hutscape/cactus/readme.md

# Cactus

> 🌵 Indoor WiFi-connected temperature and humidity sensor 🍶

Visit [hutscape.com/cactus](https://hutscape.com/cactus/) for more details.

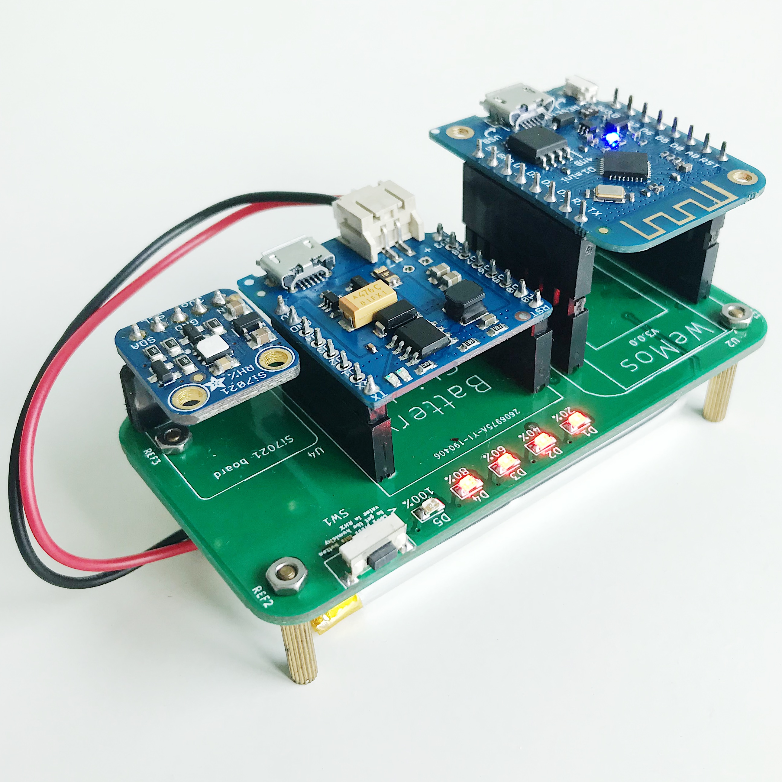
[picture p1: images/prototype/front.jpg]
