hutscape/cactus/hardware/readme.md

# Hardware

View the [schematic](images/schematic.pdf) and [footprint](images/footprint.pdf) in PDF format.

## Main components

1. PCB (1x)
1. WeMos D1 Mini `v3.0.0` (1x)
1. WeMos Battery shield `v1.1.0` (1x)
1. LiPo `1200mAh` battery with JST PH2 connector (1x)
1. `M2` nuts (4x)
1. `M2` spacers `15mm` height (4x)

Connect pins `A0` and positive `+` terminal of the LiPo JST connector on the battery shield with a `100k ohm` resistor.

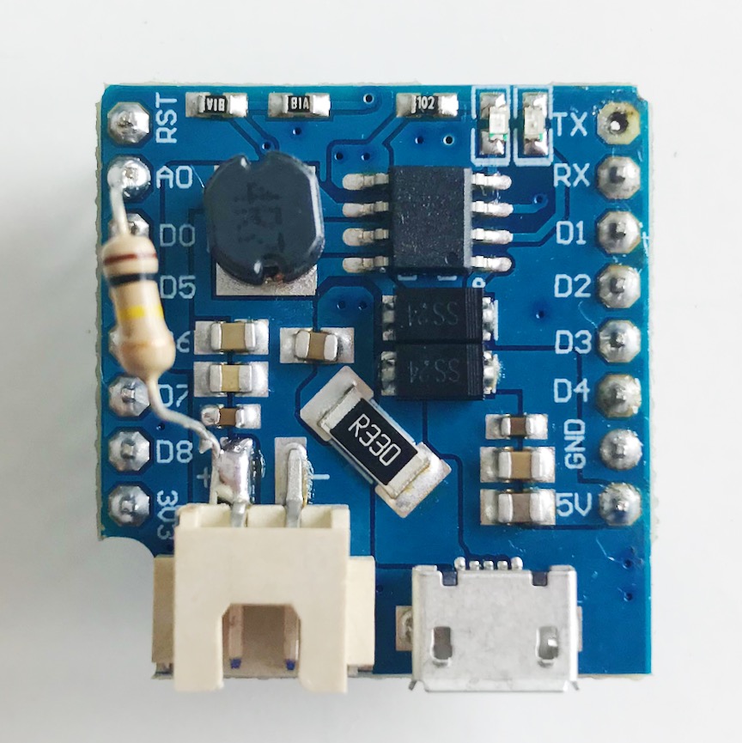
[picture p2: hardware/images/battery-shield.jpg]


## Prototype

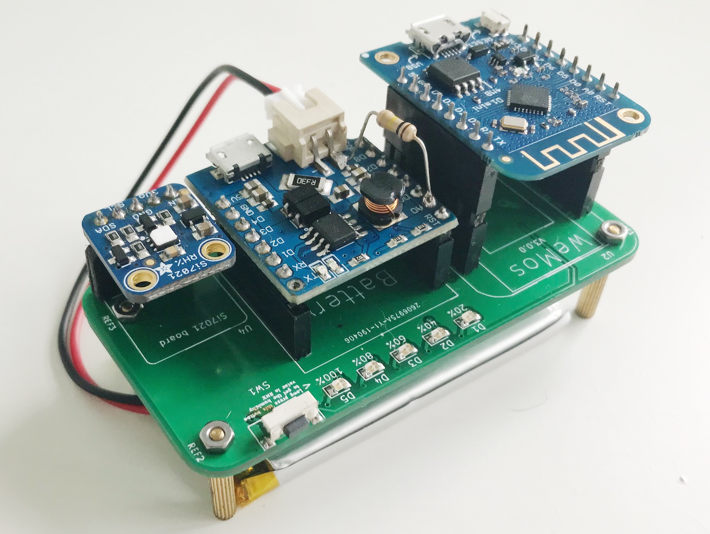
[picture p3: hardware/images/prototype-back.jpg]

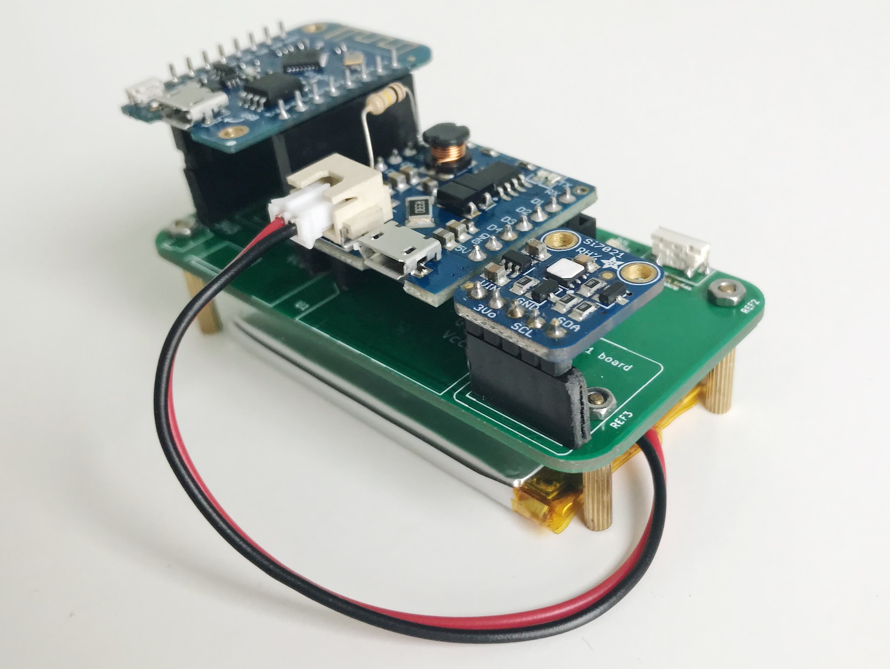
[picture p4: hardware/images/prototype-front.jpg]

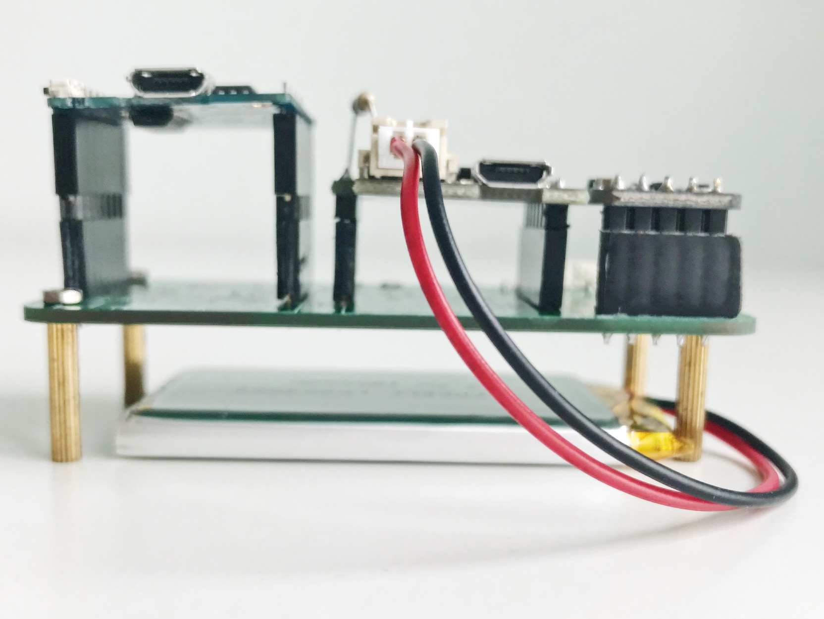
[picture p5: hardware/images/prototype-side.jpg]

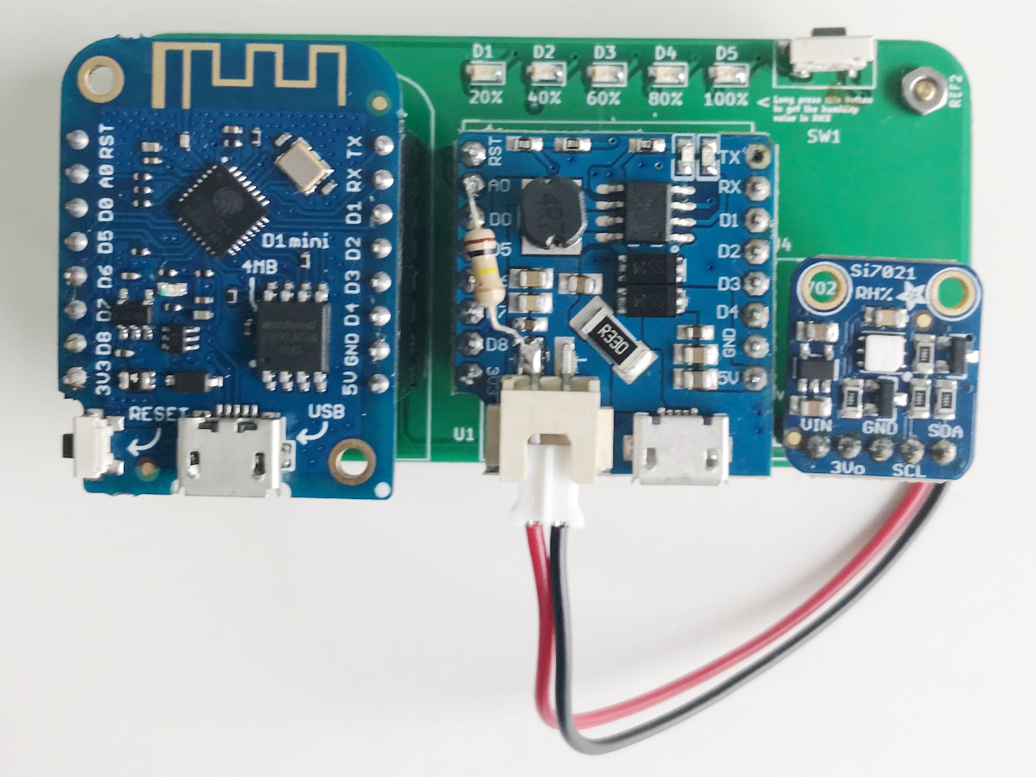
[picture p6: hardware/images/prototype-top.jpg]


## Schematic

View the [PDF](images/schematic.pdf) version

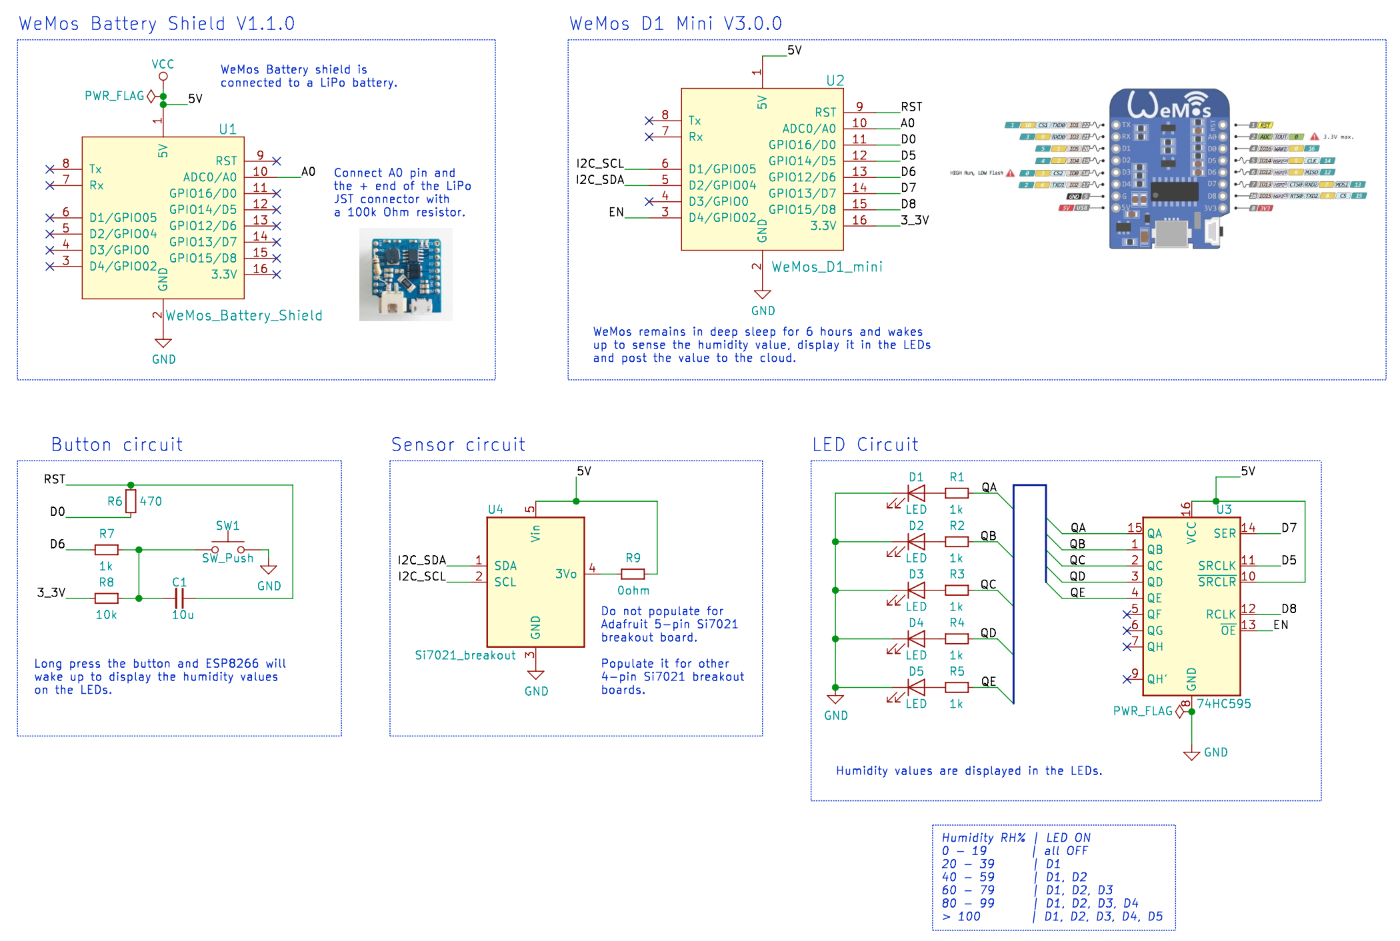
[picture p7: hardware/images/schematic.png]


## Footprint

View [PDF](images/footprint.pdf) version

Front

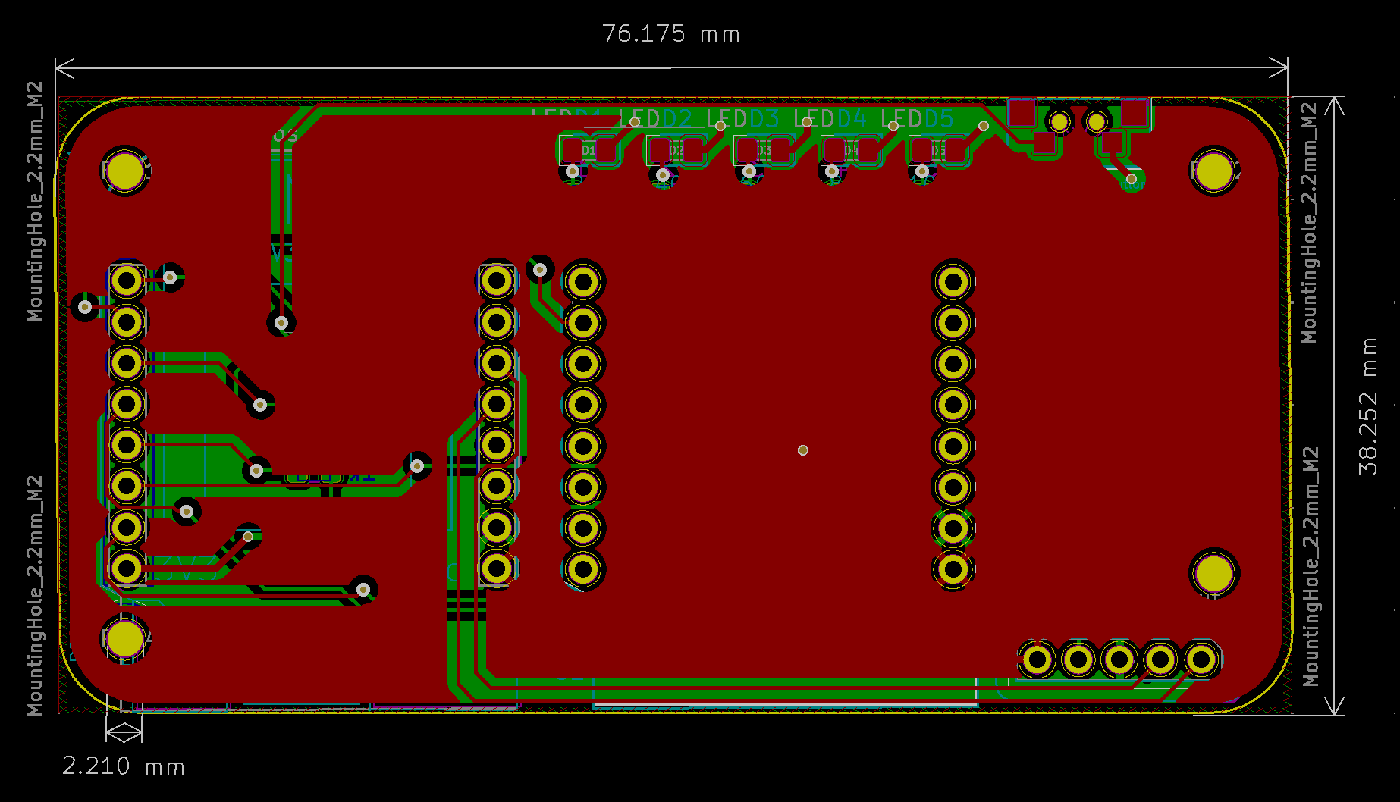
[picture p8: hardware/images/footprint-front.png]


Back

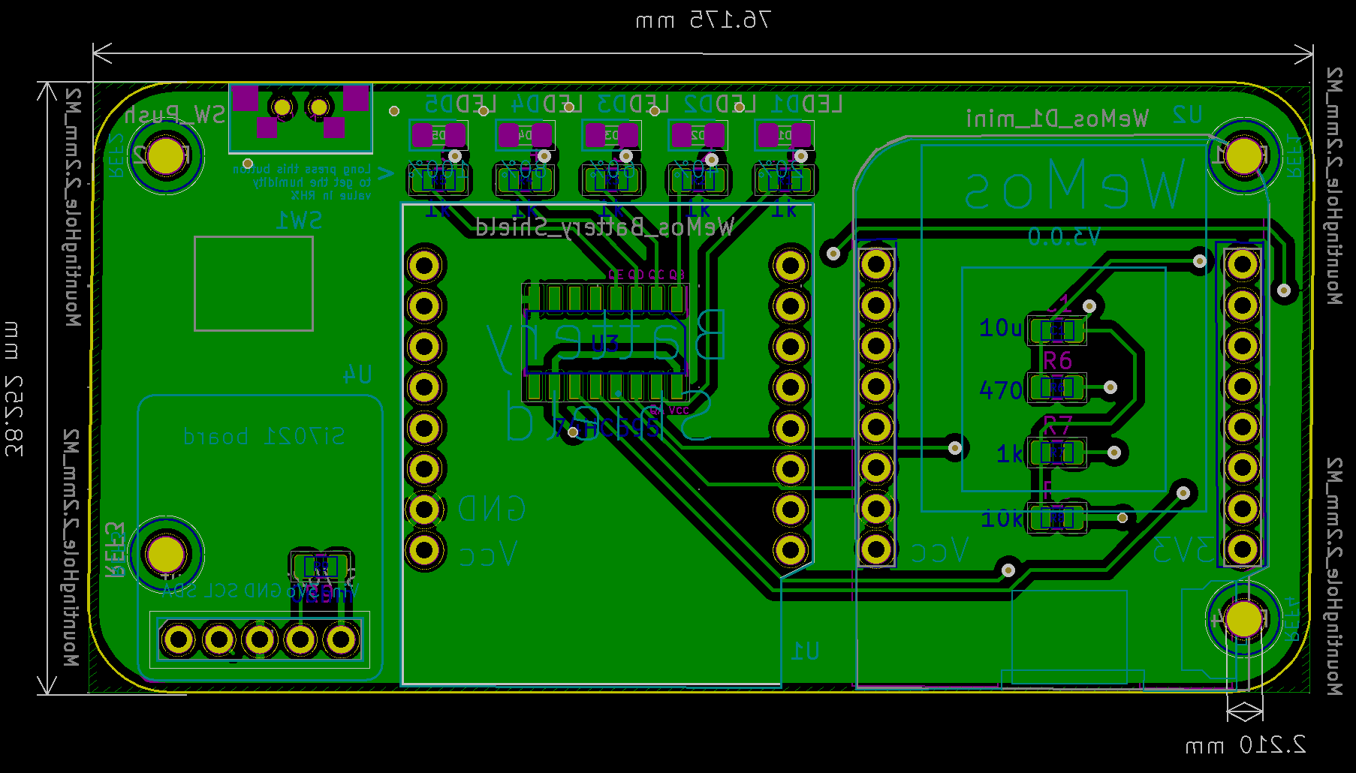
[picture p9: hardware/images/footprint-back.png]


## 3D View

Front

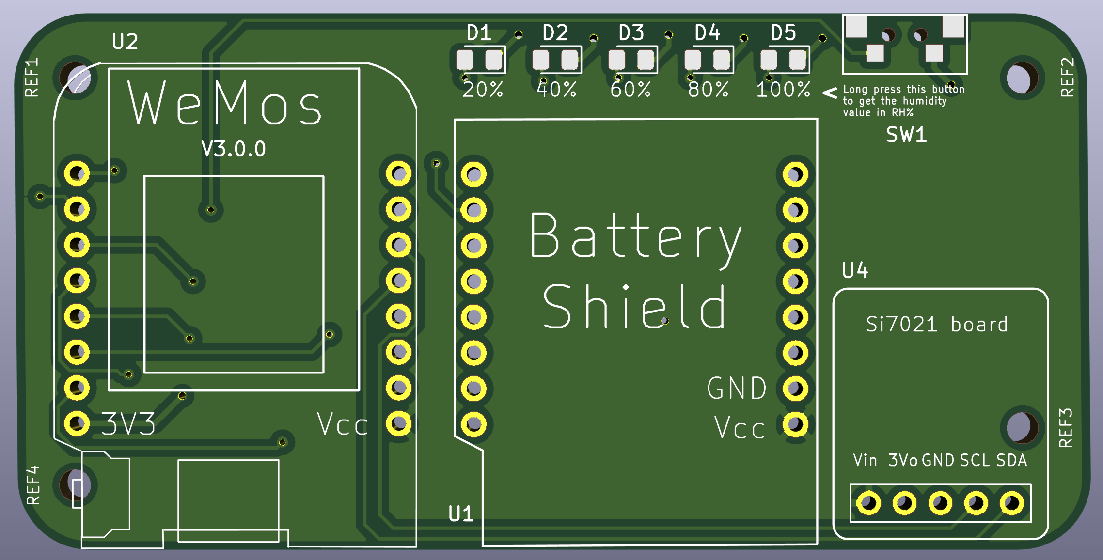
[picture p10: hardware/images/3dview-front.png]


Back

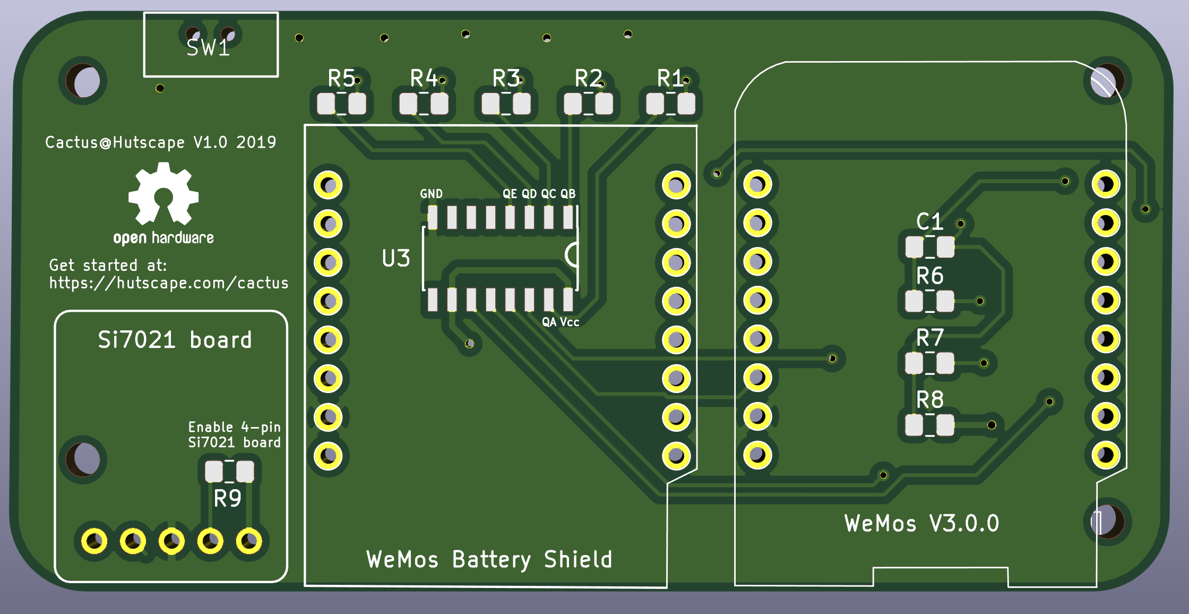
[picture p11: hardware/images/3dview-back.png]
