hutscape/cactus/design.md

---
layout: design
title: Design
permalink: /design
sequence: 5
state_machine: true

# Mechanical
items:
  - name: Name card holder box
    url: https://www.adafruit.com/product/3406
    height: 90
    width: 55
    depth: 25
    dimension_unit: mm
    comment: enclosure

  - name: PCB
    height: 76
    width: 38
    depth: 2
    dimension_unit: mm

  - name: WeMos D1 Mini V3.0.0
    url: https://wiki.wemos.cc/products:d1:d1_mini
    height: 34.2
    width: 25.6
    depth: 2
    dimension_unit: mm
    weight: 3
    weight_unit: g
    comment: pcb fit

  - name: WeMos Battery shield
    url: https://wiki.wemos.cc/products:d1_mini_shields:battery_shield
    height: 34.2
    width: 25.6
    depth: 2
    dimension_unit: mm
    comment: pcb fit

  - name: Adafruit Si7021 Breakout Board
    url: https://www.adafruit.com/product/3251
    height: 17.8
    width: 15.3
    depth: 3
    dimension_unit: mm
    weight: 1
    weight_unit: g
    comment: pcb fit

  - name: <code>500mAh</code> LiPo
    url: https://www.adafruit.com/product/1578
    height: 36
    width: 29
    depth: 4.75
    dimension_unit: mm
    weight: 10.5
    weight_unit: g
    comment: pcb fit

  - name: <code>500mAh</code> LiPo
    url: https://www.aliexpress.com/item/3-7V-500mAh-Lipo-Battery-For-Syma-X5C-X5SW-M68-Cheerson-CX-30-H5C-Quadrocopter-3/32918919539.html
    height: 43
    width: 25
    depth: 8
    dimension_unit: mm
    comment: pcb fit

  - name: <code>2000mAh</code> LiPo
    url: https://www.adafruit.com/product/2011
    height: 60
    width: 36
    depth: 7
    dimension_unit: mm
    weight: 34
    weight_unit: g
    comment: pcb fit

  - name: <code>2000mAh</code> LiPo
    url: https://www.aliexpress.com/item/3-7V-2000-mAh-Polymer-Lithium-Battery-LiPo-For-GPS-Tablet-PC-407080/2055208577.html
    height: 80
    width: 70
    depth: 4
    dimension_unit: mm

  - name: <code>2500mAh</code> LiPo
    url: https://www.adafruit.com/product/328
    height: 65
    width: 51
    depth: 8
    dimension_unit: mm
    weight: 52
    weight_unit: g
---
