hutscape/cactus/timeline.md

# Timeline

## Total duration

- **Start Date:** 10 May 2017
- End Date:

## Ideation

- **Ideation Duration:** *Not tracked*
- **Ideation Start Date:** *Not tracked*
- **Ideation End Date:** *Not tracked*
- **Prototype Parts Lead Time:** *Not tracked*
- **Order prototype parts date:** *Not tracked*
- **Receive prototype parts date:** *Not tracked*

Ideation tasks:

1. Research for modules
1. Research for similar projects
1. Research for datasheets
1. Settle on a project name
1. Research on power
1. Order modules, parts, power required for component testing
1. Note the prices for prototype items
1. Note the time taken to receive all the parts

## Prototyping

- **Prototype Testing Duration:** *Not tracked*
- **Prototype Testing Start Date:** *Not tracked*
- **Prototype Testing End Date:** *Not tracked*

Prototyping tasks:

- [x] Ensure various components work with both hardware modules and firmware
- [x] Finalize the power tree
- [x] Make a theoretical power consumption calculation
- [x] Make a mechanical and physical layout of the PCB housing

## Schematic

- **Schematic Duration:** 7 Days
- **Schematic Start Date:** [Mar 12, 2019](https://github.com/sayanee/cactus/commit/ff585d7c6959faede793e362a63a2719848d49f6)
- **Schematic End Date:** [Mar 19, 2019](https://github.com/sayanee/cactus/commit/a69e2ad4a81ffa1c7960dc5ee44be5a643a09f90)

Schematic tasks:

- [x] Create new components
- [x] Ensure DRC passes

## Mechanical

- **Mechanical Testing duration:** 9 Days
- **Mechanical Testing Start Date:** [Mar 20, 2019](https://github.com/sayanee/cactus/commit/9eb6e6a9e616c000224ddb287a9347f35d2da6c7)
- **Mechanical Testing End Date:** [Mar 29, 2019](https://github.com/sayanee/cactus/commit/85a2da56949accfd0cb8a94280c2dceeae0b87dc)

Mechanical tasks:

- [x] Create a BOM list
- [x] Ensure vendors have the stock
- [x] Ensure edge cuts can house all the components
- [x] Note all the dimensions of major components
- [x] Note all connectors to external links
- [x] Layout the PCB footprint
- [x] Ensure ERC passes
- [x] Add version, name, year, logos on the silkscreen
- [x] Add mounting holes

## Manufacturing

- **BOM receive Duration:** 16 days
- **BOM Order Date:** 4 April, 2019
- **BOM receive Date:** 22 April, 2019
- **BOM vendors:** 4 (Mouser, RS, AliExpress, 12Geeks)
- **Manufacturing PCB Duration:** 7 days
- **Manufacturing PCB Order Date:** 5 April, 2019
- **Manufacturing PCB Receive Date:** 12 April, 2019

Manufacturing tasks:

- [x] Order BOM parts online
- [x] Order PCB manufacturing online
- [ ] Note the cost per unit
- [ ] Note other charges

## System Integration

- **Integration Duration:** *Pending*
- **Integration Start Date:** 15 April, 2019
- **Integration End Date:** *Pending*

System Integration tasks:

- [x] Solder 1 unit
- [x] Ensure continuity check for all power pins
- [x] Do a power on test
- [x] Run the test firmware
- [ ] Run the full firmware

## Deployment

- **Start logging:** *Pending*

Deployment tasks:

- Start logging to monitor power consumption
