hutscape/cactus/_code/demo.md

---
layout: code
title: Demo
description: Wakup every 6 hours to read the temperature and humidity
difficulty: medium
features:
  - temperature
  - humidity
  - wifi
  - ifttt
images:
  console: demo-console.png
photos:
  - filename: serial-1.png
  - filename: serial-2.png
---

Wakeup every 6 hours to read the temperature and humidity and send that value to IFTTT.
