hutscape/cactus/pcb/pcb.md

---
layout: pcb
title: PCB
permalink: /pcb
sequence: 2

# maximum number of images prototype-n.jpg in folder images/pcb/prototype
max_prototype_images: 2
---
