hutscape/cactus/images/code/demo-console.png

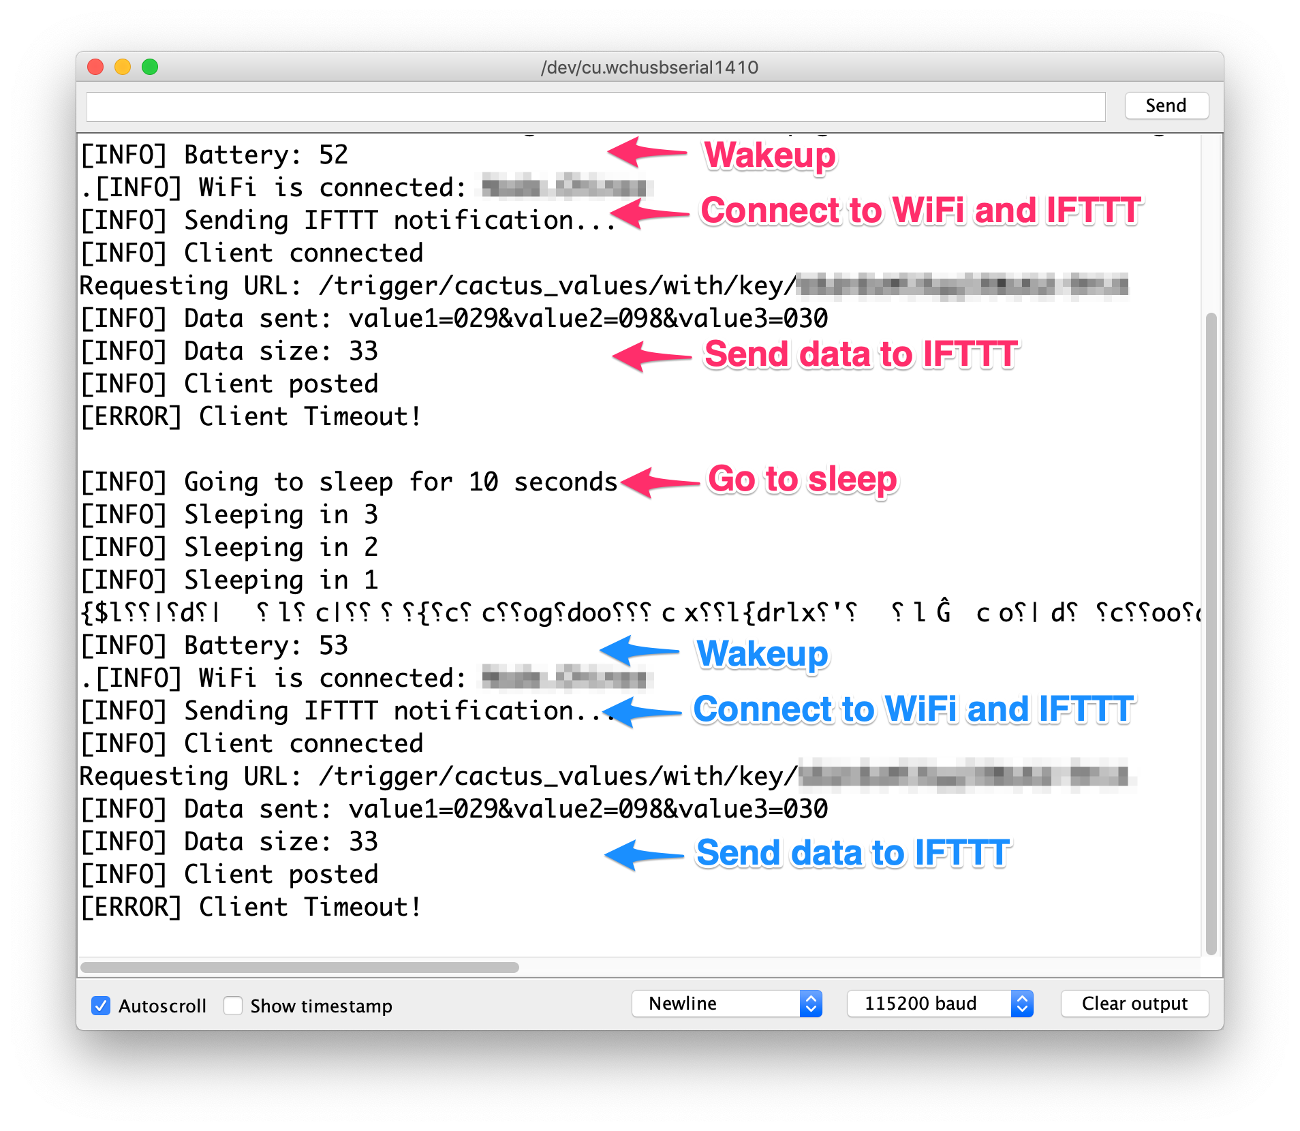
images/code/demo-console.png
