hutscape/cactus/images/code/serial-1.png

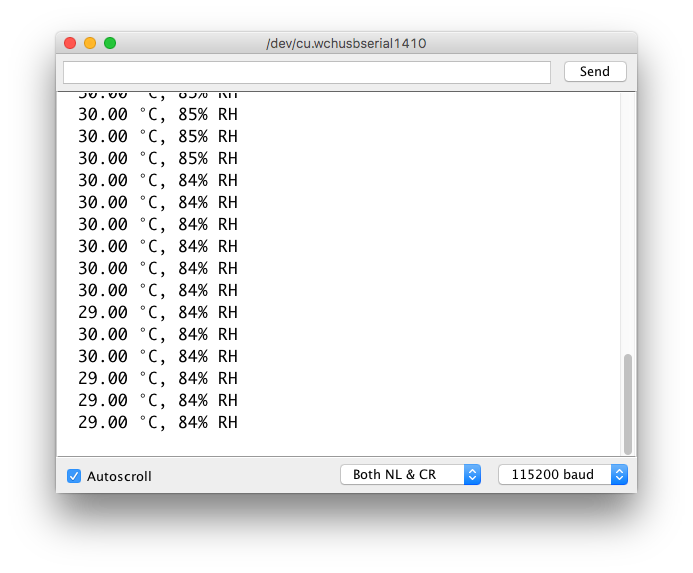
images/code/serial-1.png
