hutscape/cactus/images/code/serial-2.png

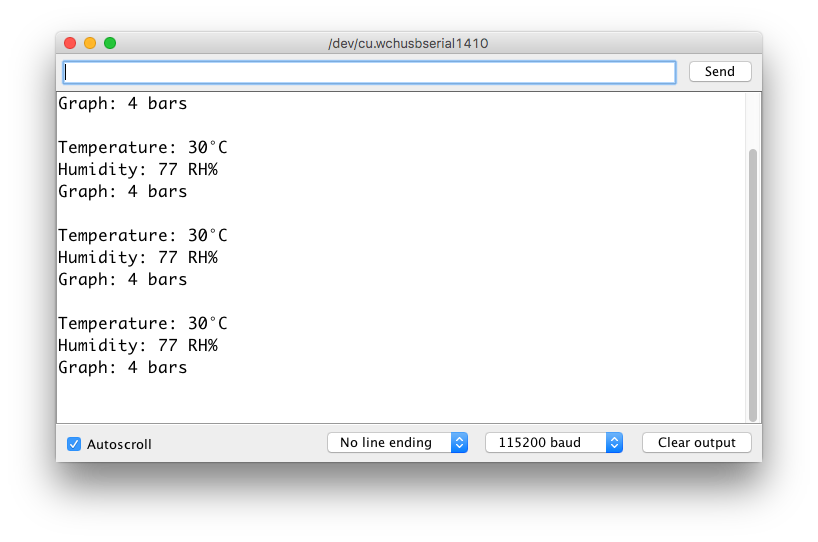
images/code/serial-2.png
