hutscape/cactus/images/code/settings.png

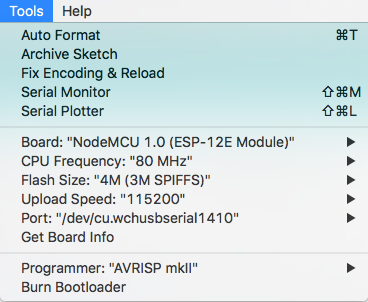
images/code/settings.png
