hutscape/cactus/images/prototype/back.jpg

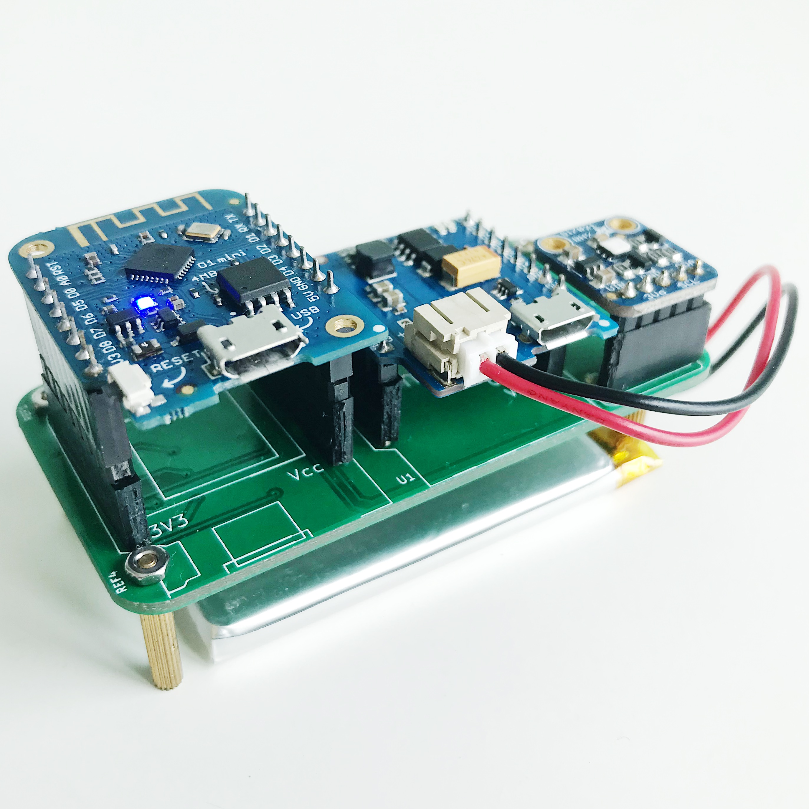
images/prototype/back.jpg
