hutscape/cactus/images/prototype/prototype-1.jpg

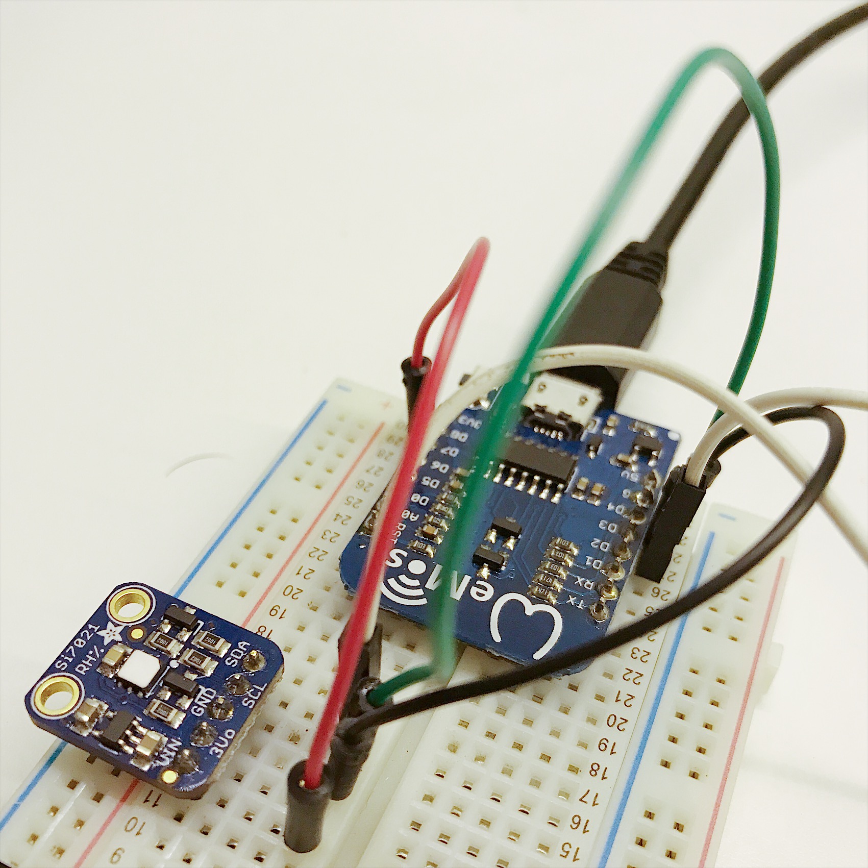
images/prototype/prototype-1.jpg
