hutscape/cactus/images/prototype/side.jpg

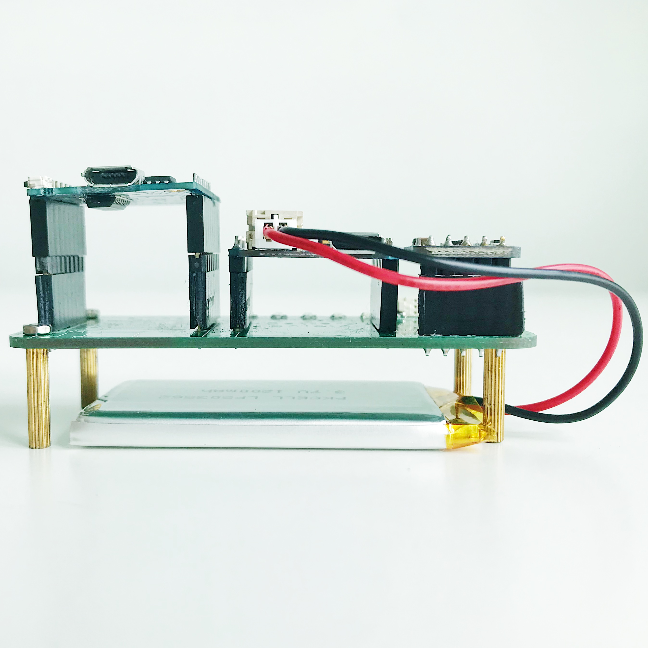
images/prototype/side.jpg
