hutscape/cactus/images/prototype/top.jpg

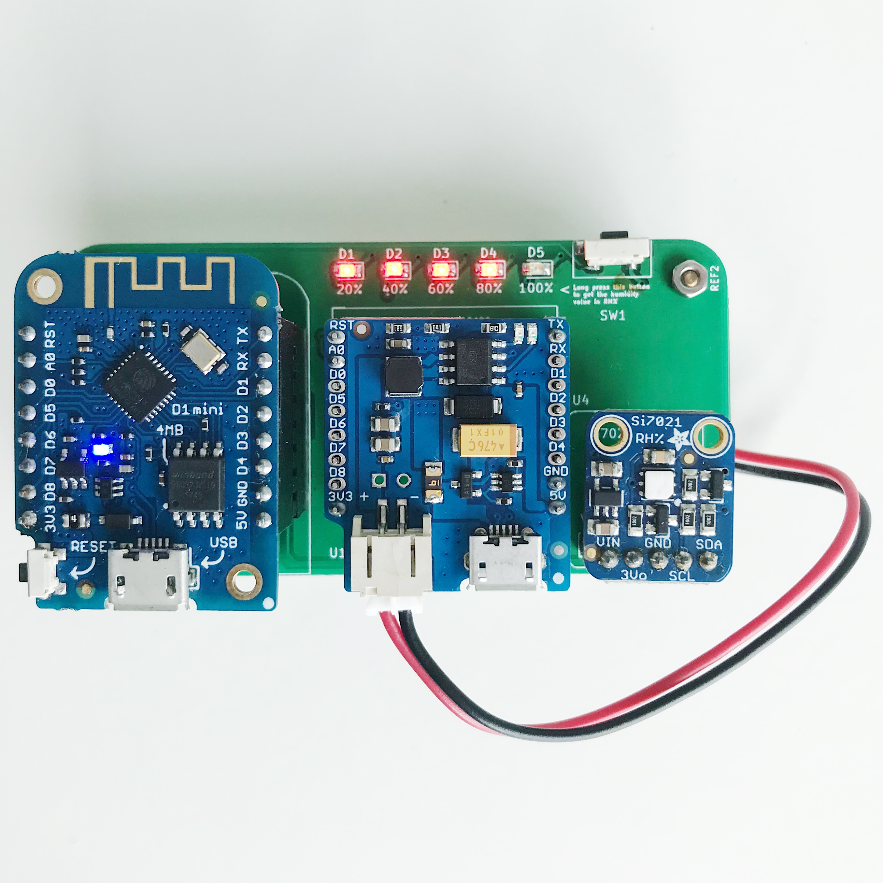
images/prototype/top.jpg
