hutscape/cactus/components/ifttt/readme.md

# IFTTT

Display humidity in a bar graph LED and send to IFTTT periodically

## Hardware

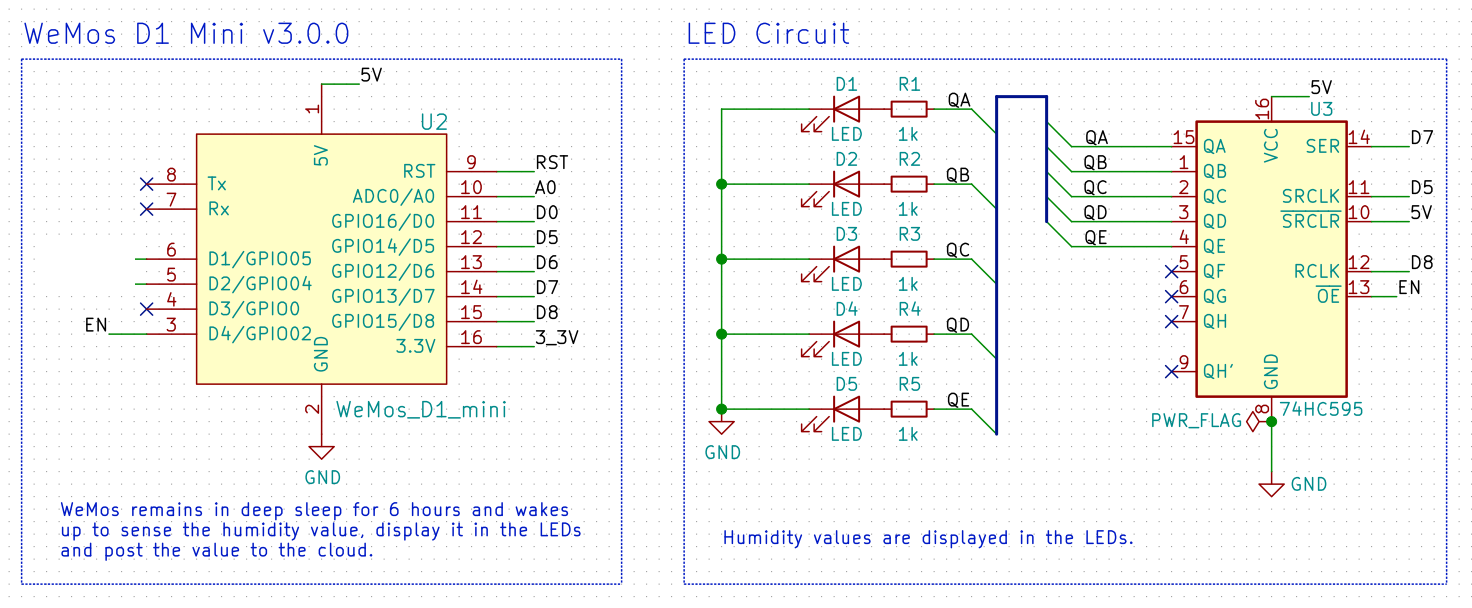
[picture p29: components/shift-register/schematic.png]
Shift register


## Firmware

[Arduino code](main.ino)
