hutscape/cactus/bom.md

---
layout: bom
title: Bill of Materials
permalink: /bom
sequence: 4
ibom: true
---
