hutscape/cactus/start/step3.md

**Update Google Sheets with the data**

Press on-board button or wait for the [Google Sheet](https://docs.google.com/spreadsheets/d/1qedLXiCeU6vCwEvv3JqwrVWjrriB8L3DA9Xp-g01Jk0/edit?usp=sharing) to update with a new row with a periodic update to the cloud.

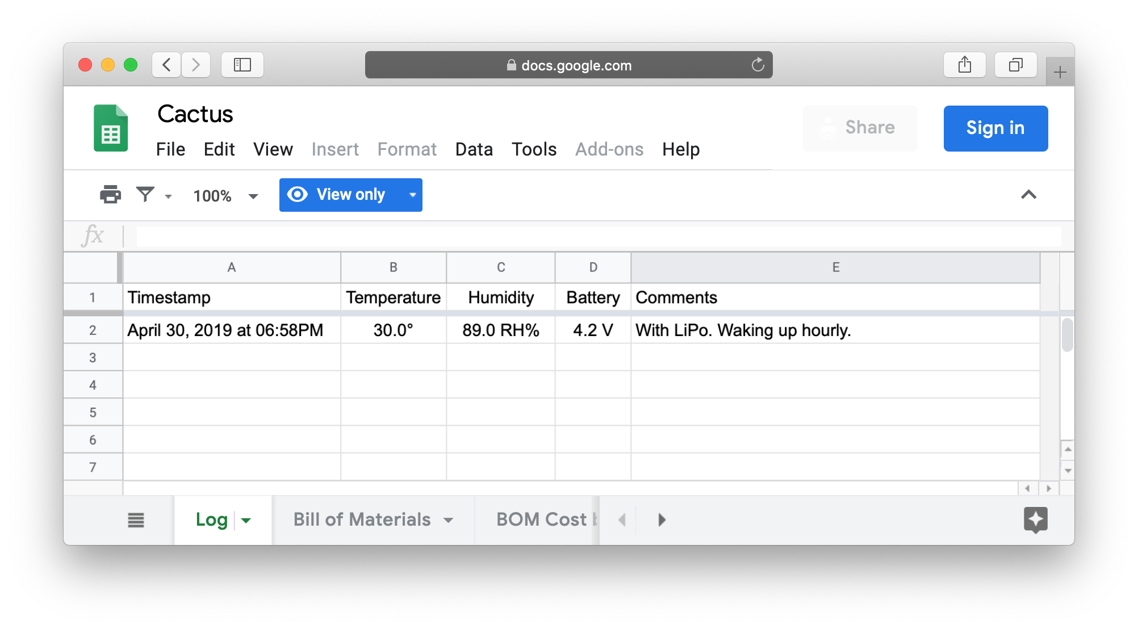
[picture p30: images/start/google-sheet.png]
Google sheets
