hutscape/cactus/start/step1.md

Setup an [IFTTT webhook](https://ifttt.com/services/maker_webhooks) to receive a POST request with data and add a row to a Google Spreadsheet.

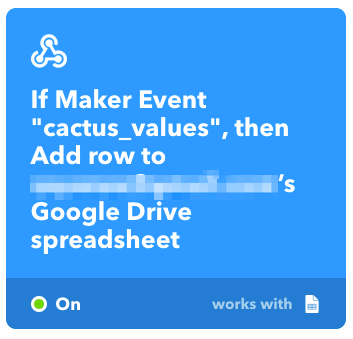
[picture p31: images/start/ifttt.png]
