hutscape/cactus/start/step2.md

**Access Point**

Connect to the WiFi access point `Cactus {UNIQUE_MAC_ADDRESS}`.

Go to the web page `http://cactus.local` to fill in the WiFi credentials and [IFTTT webhook key](https://ifttt.com/services/maker_webhooks/settings).

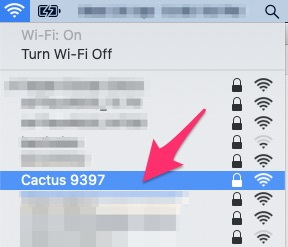
[picture p32: images/start/access_point.jpg]
Access point


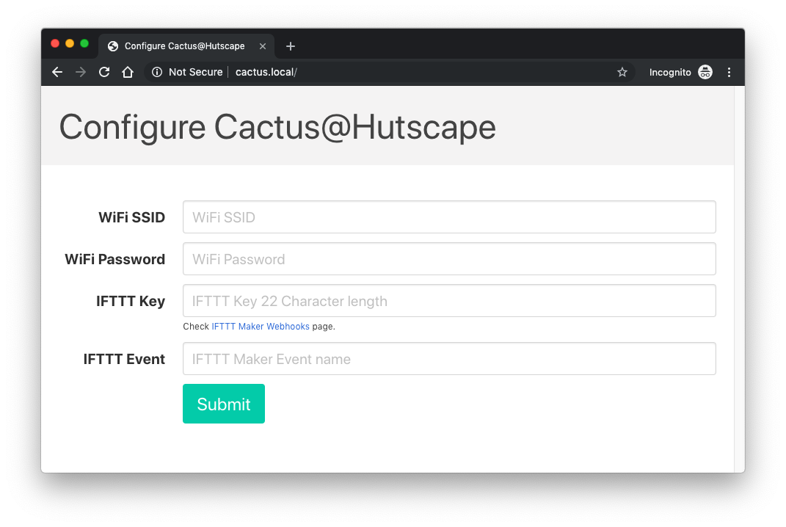
[picture p33: images/start/webpage.png]
Webpage form
