hutscape/cactus/components/measure-battery-level/readme.md

# Measure Battery Level

> Measure the LiPo battery voltage

## Getting started

1. Connect `100k` resistor from `A0` to JST connector's positive terminal
1. Flash the [firmware](measure-battery-level.ino)
1. Connect to access point `Cactus XXXX` with password `hutscape`
1. Get the current battery voltage by accessing `192.168.4.1`

## Reference

- [Monitoring LiPo battery voltage with Wemos D1 minibattery shield and Thingspeak](https://arduinodiy.wordpress.com/2016/12/25/monitoring-lipo-battery-voltage-with-wemos-d1-minibattery-shield-and-thingspeak/)
