hutscape/cactus/_code/test.md

---
layout: code
title: Cactus test
description: Test that all features work
difficulty: medium
features:
  - temperature
  - humidity
  - wifi
  - ifttt
images:
  console: test-console.png
photos:
  - filename: serial-1.png
  - filename: serial-2.png
---
Run a suite of 10 tests.
