hutscape/cactus/(threads)

Thread 1 (2017-06-12):

read and display humidity on push button

sayanee, 2017-06-12:
## Components

1.  📊 [LED](http://sg.element14.com/multicomp/mcl-s290yc/led-smd-0603-yellow/dp/1581246) SMD single color x 5 for bar chart
    - [bar graph LED tutorial](https://www.arduino.cc/en/Tutorial/BarGraph)
    - [LED tutorial](https://learn.adafruit.com/adafruit-arduino-lesson-4-eight-leds?view=all)
1. 🔘 [push button](http://sg.element14.com/omron-electronic-components/b3fs-1000/switch-spst-no-0-05a-24vdc-smd/dp/3121161) SMD
1. [Shift register](http://sg.element14.com/nxp/74hc595d/ic-74hc-cmos-smd-74hc595-soic16/dp/1201269)
    - [Arduino shift out](https://www.arduino.cc/en/Tutorial/ShiftOut)

Example of PCB design with individual LEDs to display a chart:

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

Closed 2019-03-27.

Thread 2 (2017-06-21):

bar led + shift register + arduino

sayanee, 2017-06-21:
- Wiring for 74HC595
    1. GND `pin 8` to `GND`
    1. Vcc `pin 16` to `5V`
    1. OE `pin 13` to `GND`
    1. MR `pin 10`to `5V`
    1. DS `pin 14` to Digital `pin 11` on Arduino
    1. SH_CP `pin 11` to Digital `pin 12` on Arduino
    1. ST_CP `pin 12` to Digital `pin 8` on Arduino
    1. `pin 1` to `1kΩ` resistor and `GND`
    1. `pin 2` to `1kΩ` resistor and `GND`
    1. `pin 3` to `1kΩ` resistor and `GND`
    1. `pin 4` to `1kΩ` resistor and `GND`
    1. `pin 5` to `1kΩ` resistor and `GND`
    1. `pin 6` to `1kΩ` resistor and `GND`
    1. `pin 7` to `1kΩ` resistor and `GND`
    1. `pin 15` to `1kΩ` resistor and `GND`
- Code

```c
int latchPin = 8;
int clockPin = 12;
int dataPin = 11;

void setup() {
  pinMode(latchPin, OUTPUT);
  pinMode(clockPin, OUTPUT);
  pinMode(dataPin, OUTPUT);
}

void loop() {
  shiftOut(dataPin, clockPin, LSBFIRST, 1); // Try MSBFIRST and digits 1 to 2^8 (8 led)
  digitalWrite(latchPin, HIGH);
}
```

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

Closed 2017-06-27.

Thread 3 (2017-06-21):

bar led + shift register + nodeMCU

sayanee, 2017-06-21:
Related to #2

- Reference
  - [Arduino ShiftOut on nodeMCU](https://gist.github.com/42Bots/54711c9536ef69afad7f3b9aacebb942)
- Wiring for 74HC595
    1. DS `pin 14` to Digital `pin D7` on nodeMCU (data pin)
    1. SH_CP `pin 11` to Digital `pin D5` on nodeMCU (clock pin)
    1. ST_CP `pin 12` to Digital `pin D8` on nodeMCU (latch pin)
    1. GND `pin 8` to `GND`
    1. Vcc `pin 16` to `5V`
    1. OE `pin 13` to `GND`
    1. MR `pin 10`to `5V`
    1. `pin 1` to `1kΩ` resistor and `GND`
    1. `pin 2` to `1kΩ` resistor and `GND`
    1. `pin 3` to `1kΩ` resistor and `GND`
    1. `pin 4` to `1kΩ` resistor and `GND`
    1. `pin 5` to `1kΩ` resistor and `GND`
    1. `pin 6` to `1kΩ` resistor and `GND`
    1. `pin 7` to `1kΩ` resistor and `GND`
    1. `pin 15` to `1kΩ` resistor and `GND`
- Code

```c
int latchPin = 15; // pin D8 on NodeMCU boards
int clockPin = 14; // pin D5 on NodeMCU boards
int dataPin = 13; // pin D7 on NodeMCU boards

void setup() {
  pinMode(latchPin, OUTPUT);
  pinMode(clockPin, OUTPUT);
  pinMode(dataPin, OUTPUT);
}

void loop() {
  shiftOut(dataPin, clockPin, MSBFIRST, 1); // Try LSBFIRST and digits from 1 to 2^8 (8 leds)
  digitalWrite(latchPin, HIGH);
}
```

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

Closed 2017-06-27.

Thread 5 (2017-07-25):

experiment if 2AA works without an LDO

sayanee, 2017-07-25:
put a `0Ω` resistor so that the same PCB layout can be used for both 3AA with LDO and 2AA without LDO

Related to https://github.com/sayanee/belle/issues/20

sayanee, 2019-03-13:
Using a [battery shield with LiPO](https://wiki.wemos.cc/products:d1_mini_shields:battery_shield) instead

Closed 2019-03-13.

Thread 6 (2017-08-27):

Design a PCB with mechanical considerations

sayanee, 2017-08-27:
# Mechanical considerations

1. Place the PCB on top of the 2 AA battery holders
1. Connect the battery wires on one of the shorter edge of the PCB
1. Solder the ESP-12F on the other shorter edge of the PCB
1. Bar LEDs are lining up on the longer edge of the PCB

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

Closed 2019-03-27.

Thread 7 (2019-03-13):

Remove bus from schematic connecting shift register and the LEDs

sayanee, 2019-03-13:
coz it is confusing

sayanee, 2019-03-13:
Changed the bus to a U-shaped one: 740955416fde873fba71c8f2cddf165baa82af08

Closed 2019-03-13.

Thread 8 (2019-03-13):

Check to see which battery shield pins need to be connected to WeMos

sayanee, 2019-03-13:
Connect only those pins and not anything else.

Check the [battery shield schematic](https://wiki.wemos.cc/products:d1_mini_shields:battery_shield).

sayanee, 2019-03-13:
Connected only `5V` and `GND` with `A0` 740955416fde873fba71c8f2cddf165baa82af08

Closed 2019-03-13.

Thread 11 (2019-12-09):

Blink LED consistently if the sensor Si7021 is not plugged into the board

sayanee, 2019-12-09:
Currently, the LED on-board is flickering a few seconds and it is confusing to know what is wrong
