hutscape/cactus/pcb/docs/schematic.pdf

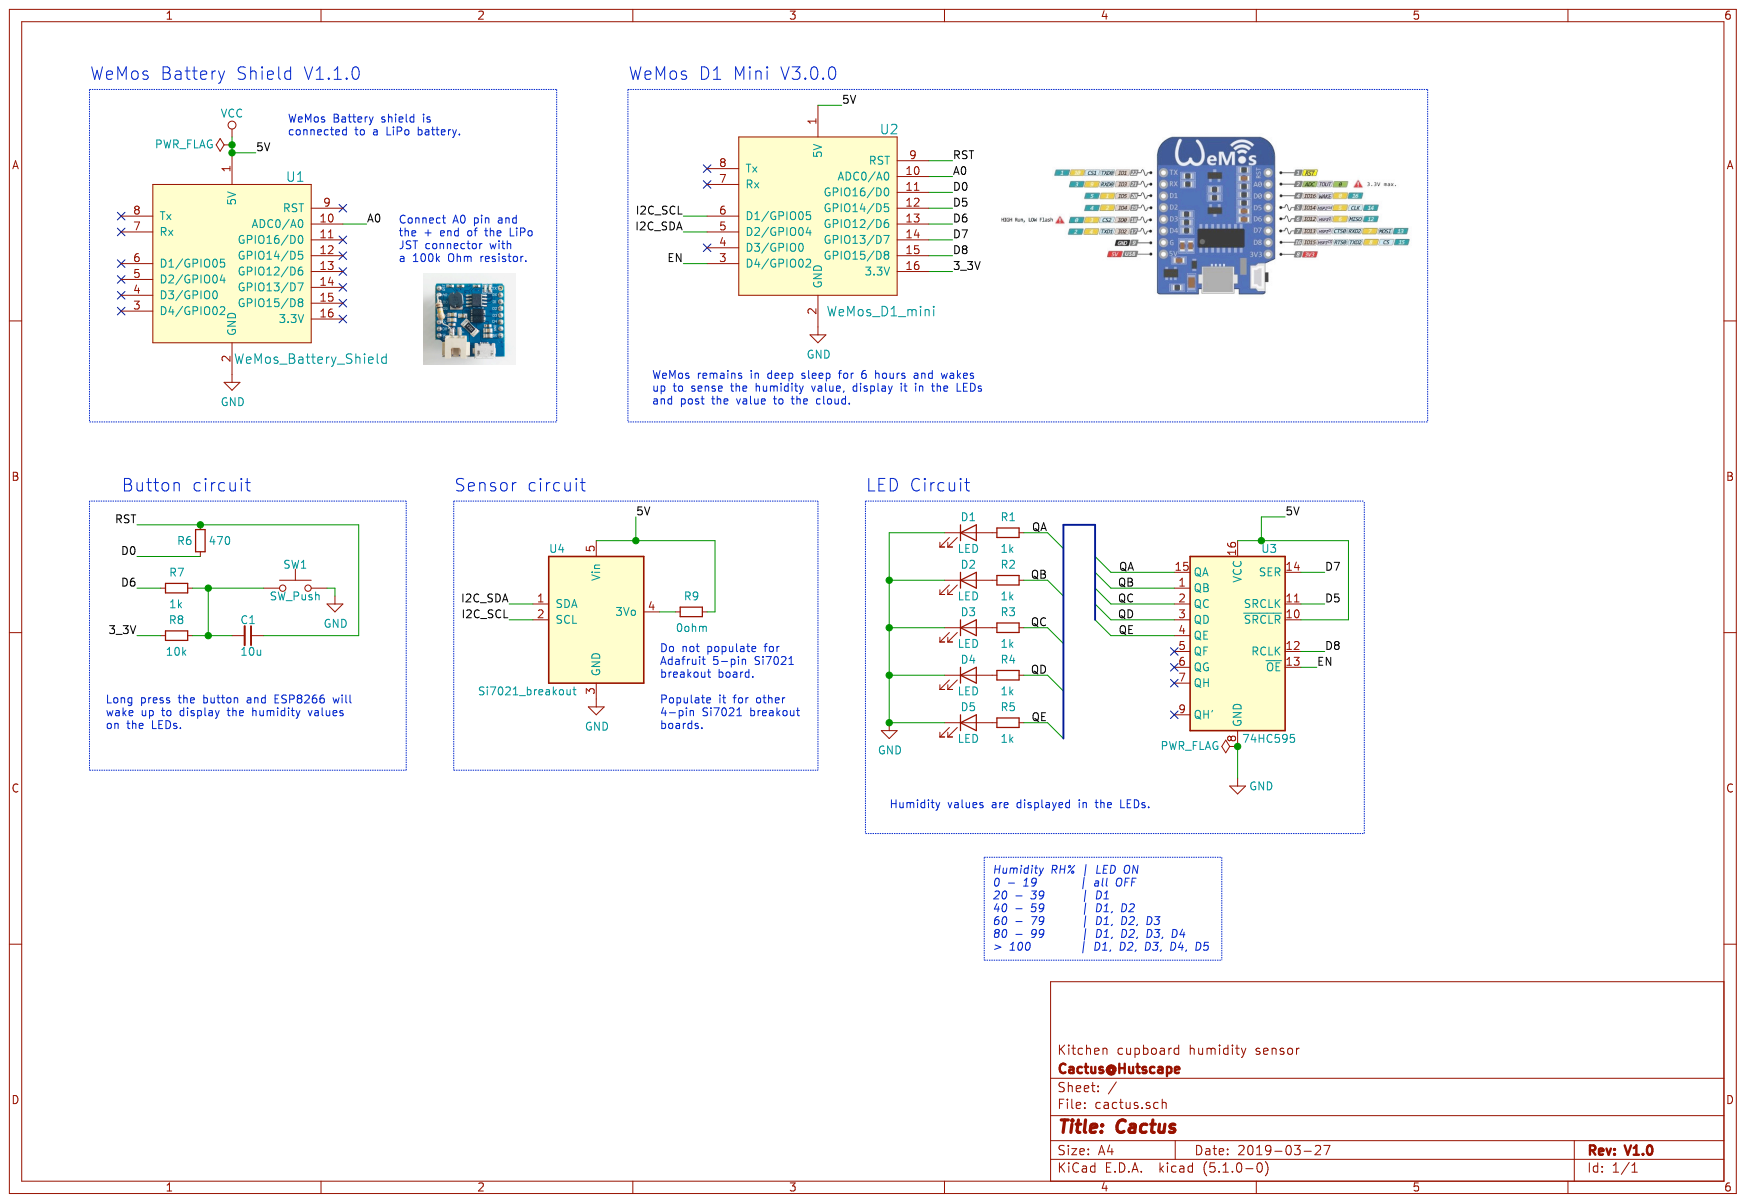
[picture p35: page 1]
