hutscape/cactus/pcb/docs/layout.pdf

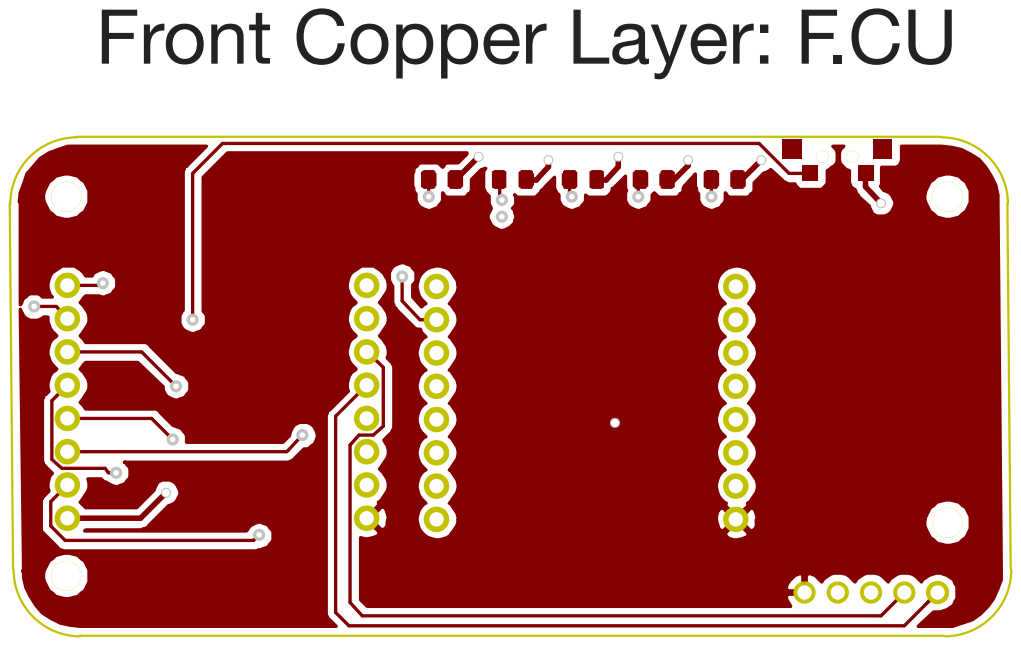
[picture p36: page 1]

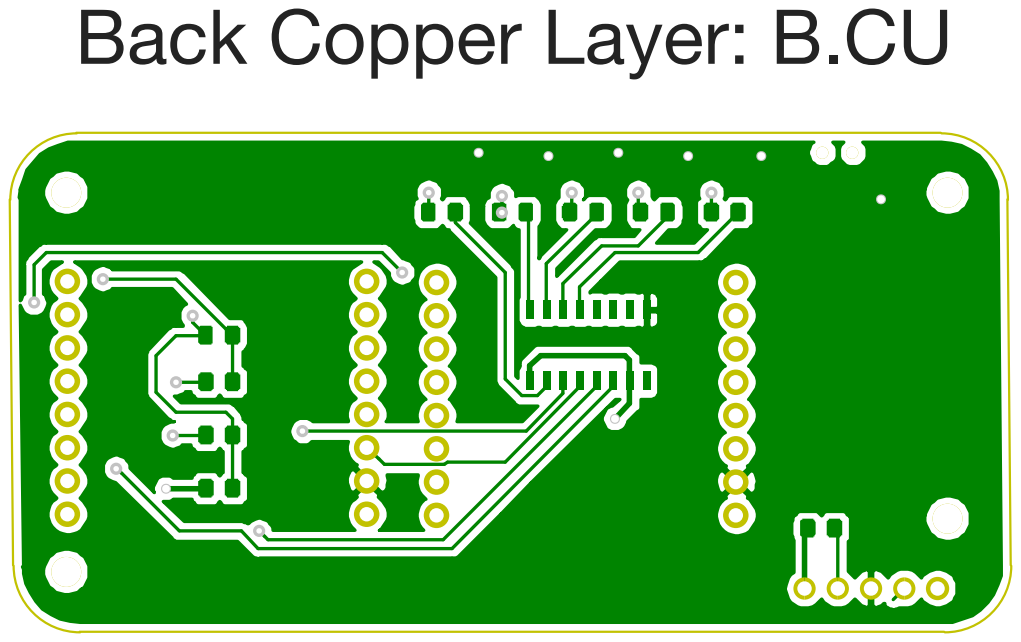
[picture p37: page 2]

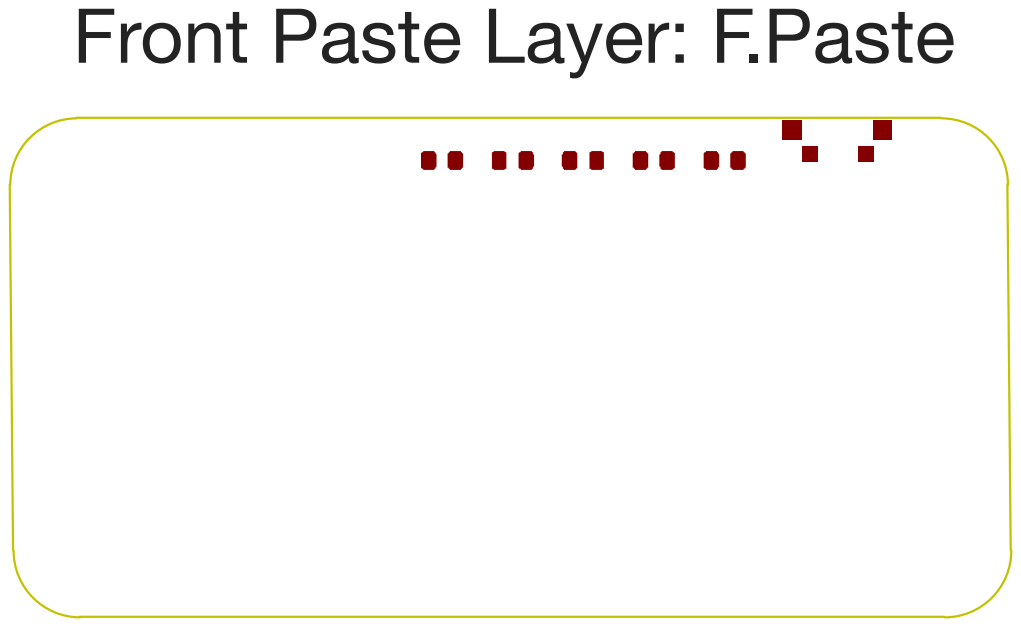
[picture p38: page 3]

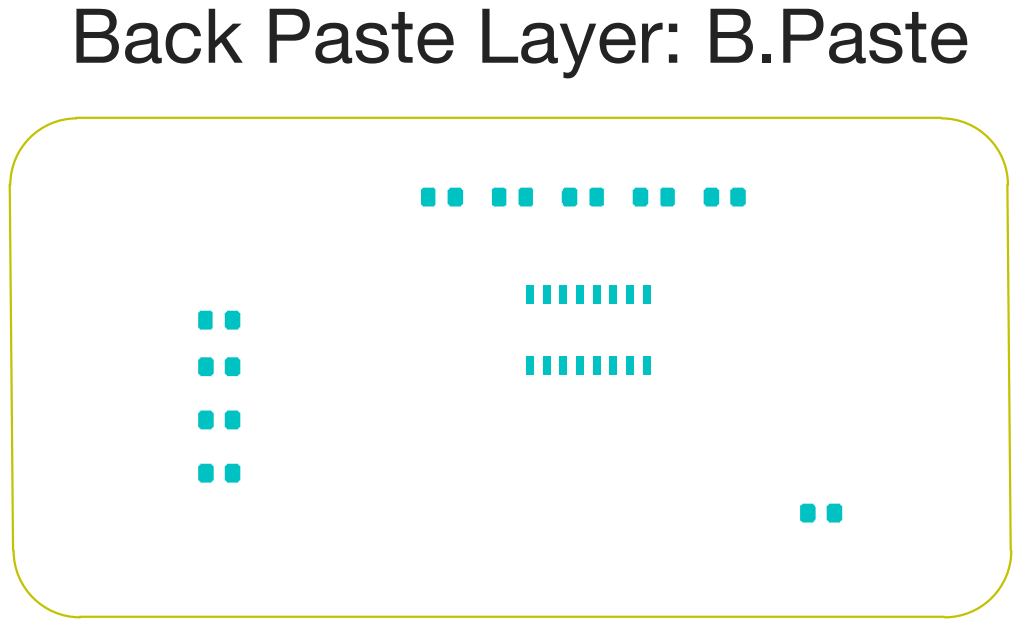
[picture p39: page 4]

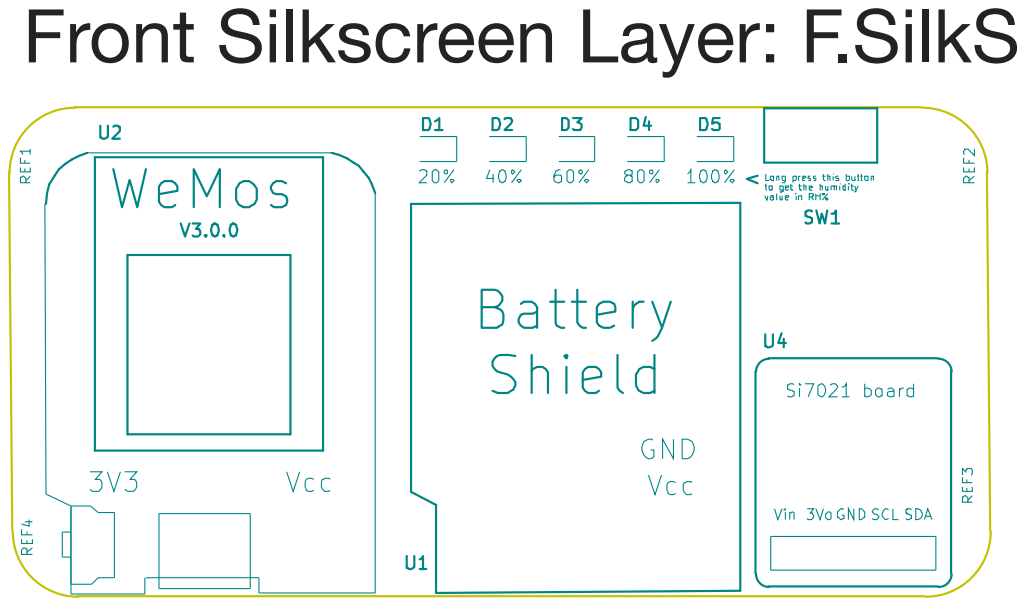
[picture p40: page 5]

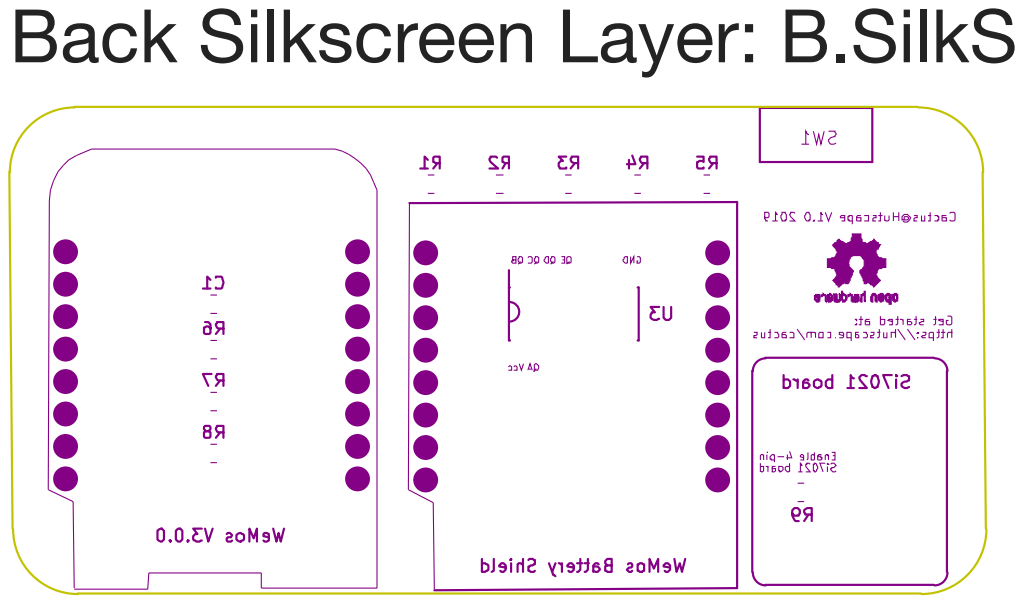
[picture p41: page 6]

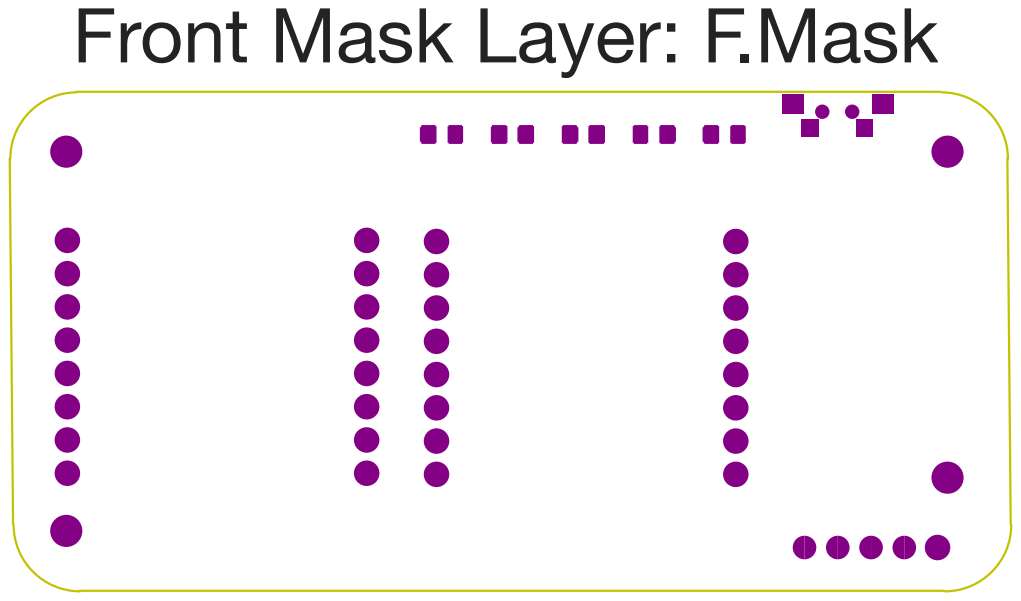
[picture p42: page 7]

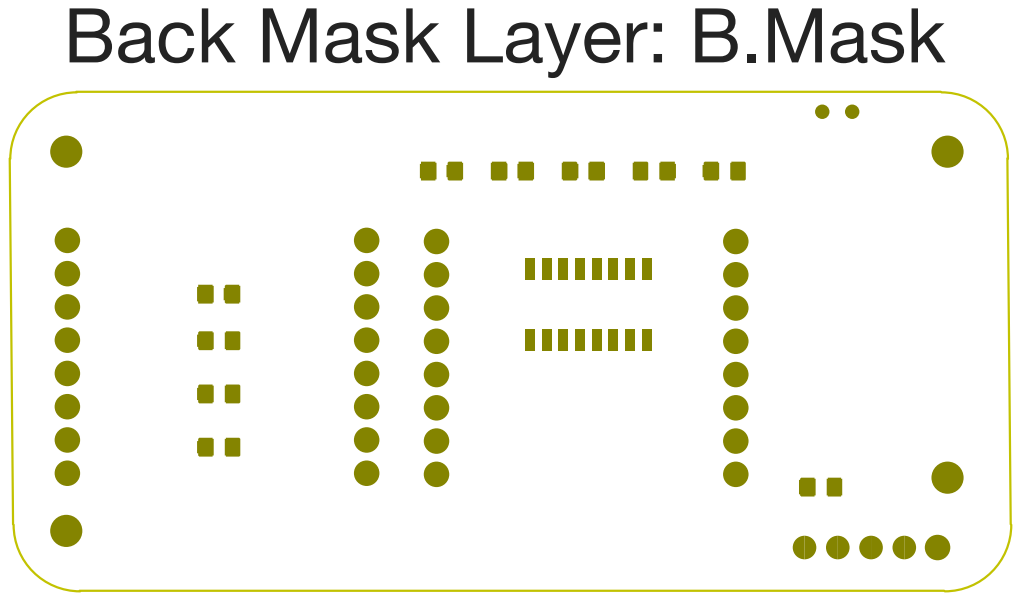
[picture p43: page 8]

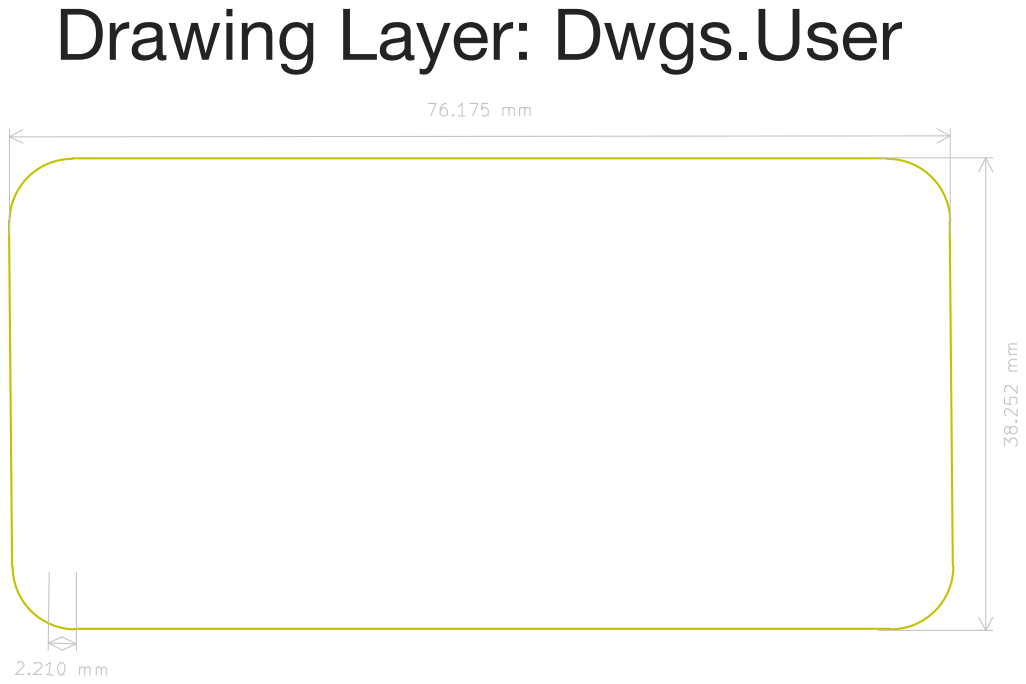
[picture p44: page 9]

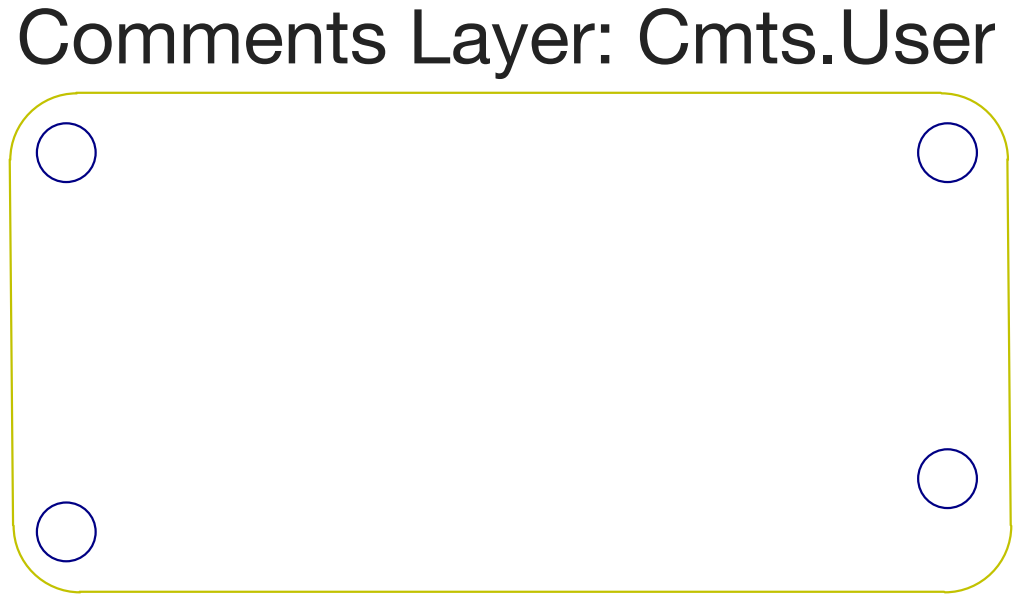
[picture p45: page 10]

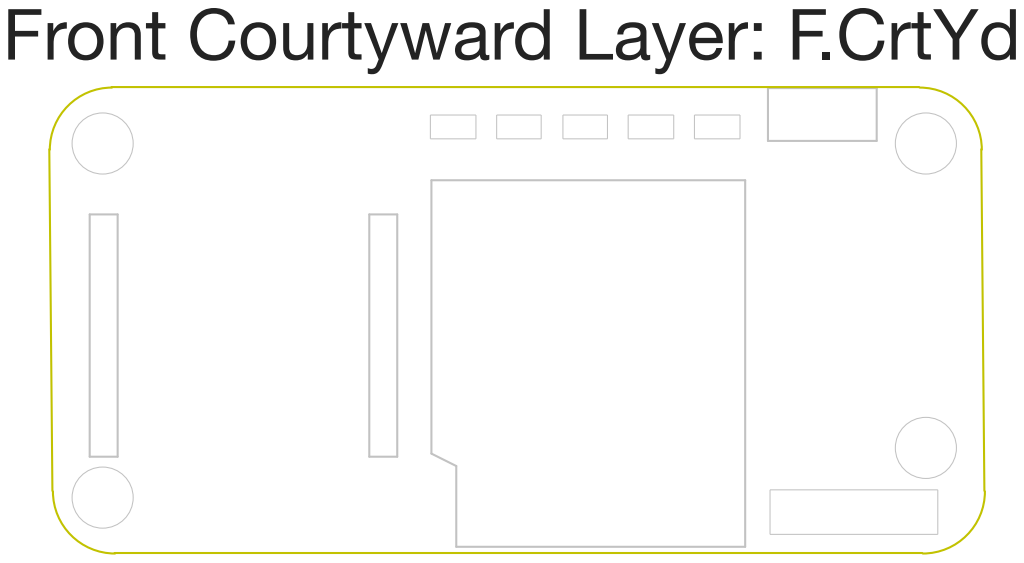
[picture p46: page 12]

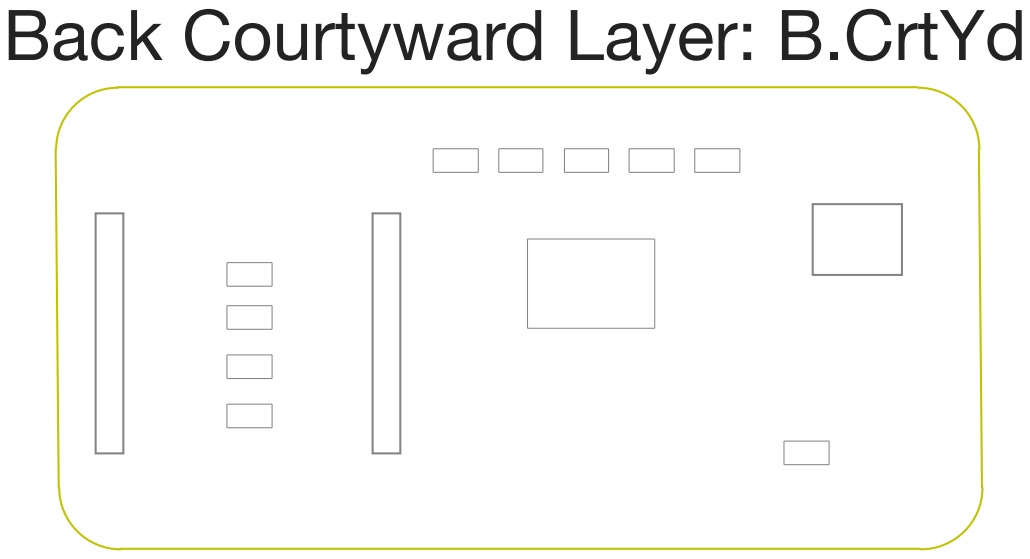
[picture p47: page 13]

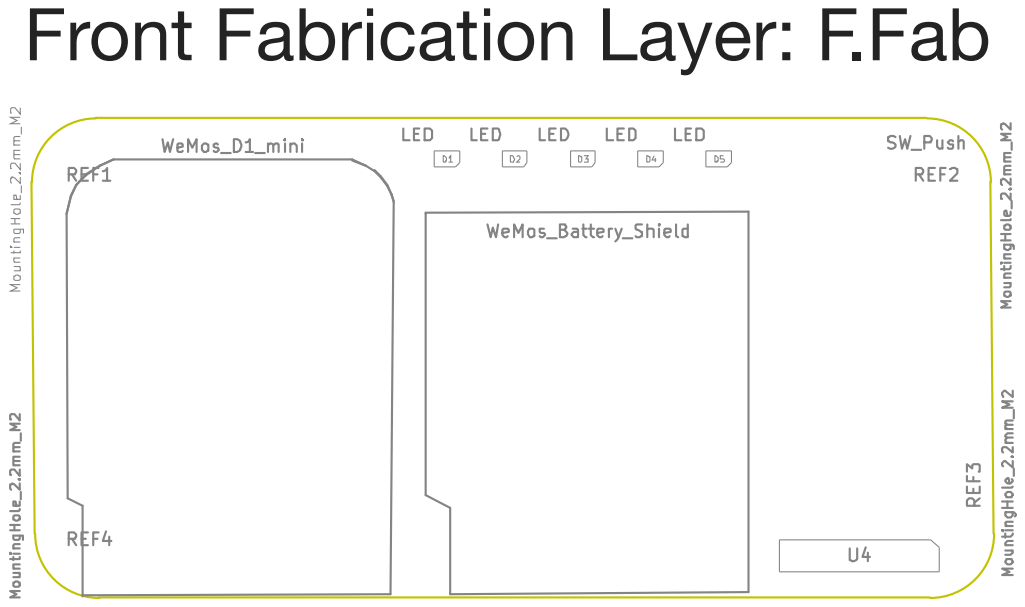
[picture p48: page 14]

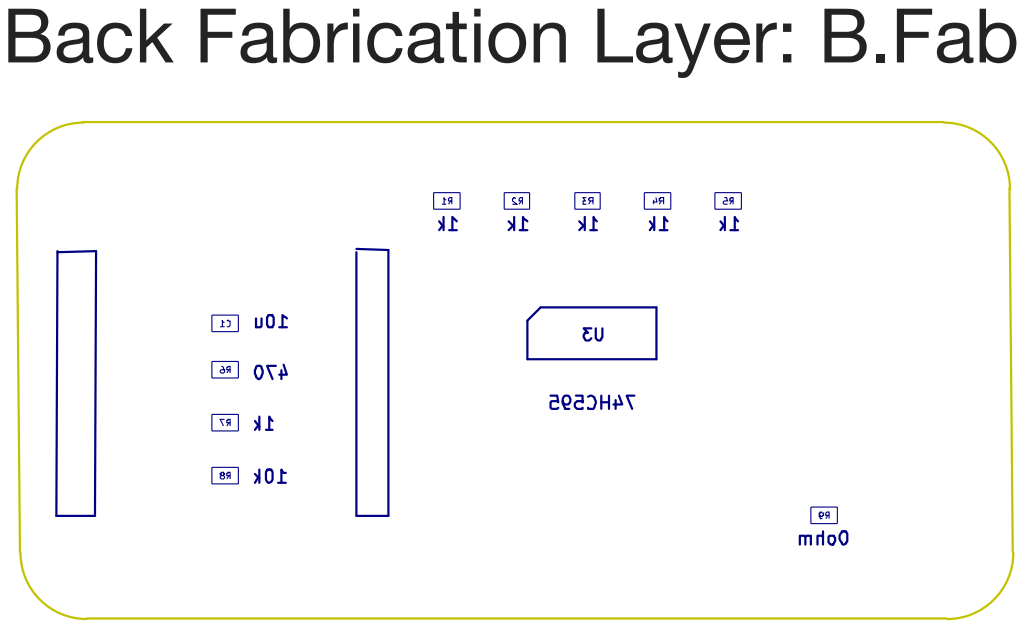
[picture p49: page 15]
