hutscape/cactus/pcb/cactus.kicad_pcb

## KiCad design pcb/cactus.kicad_pcb (2022-03-18)

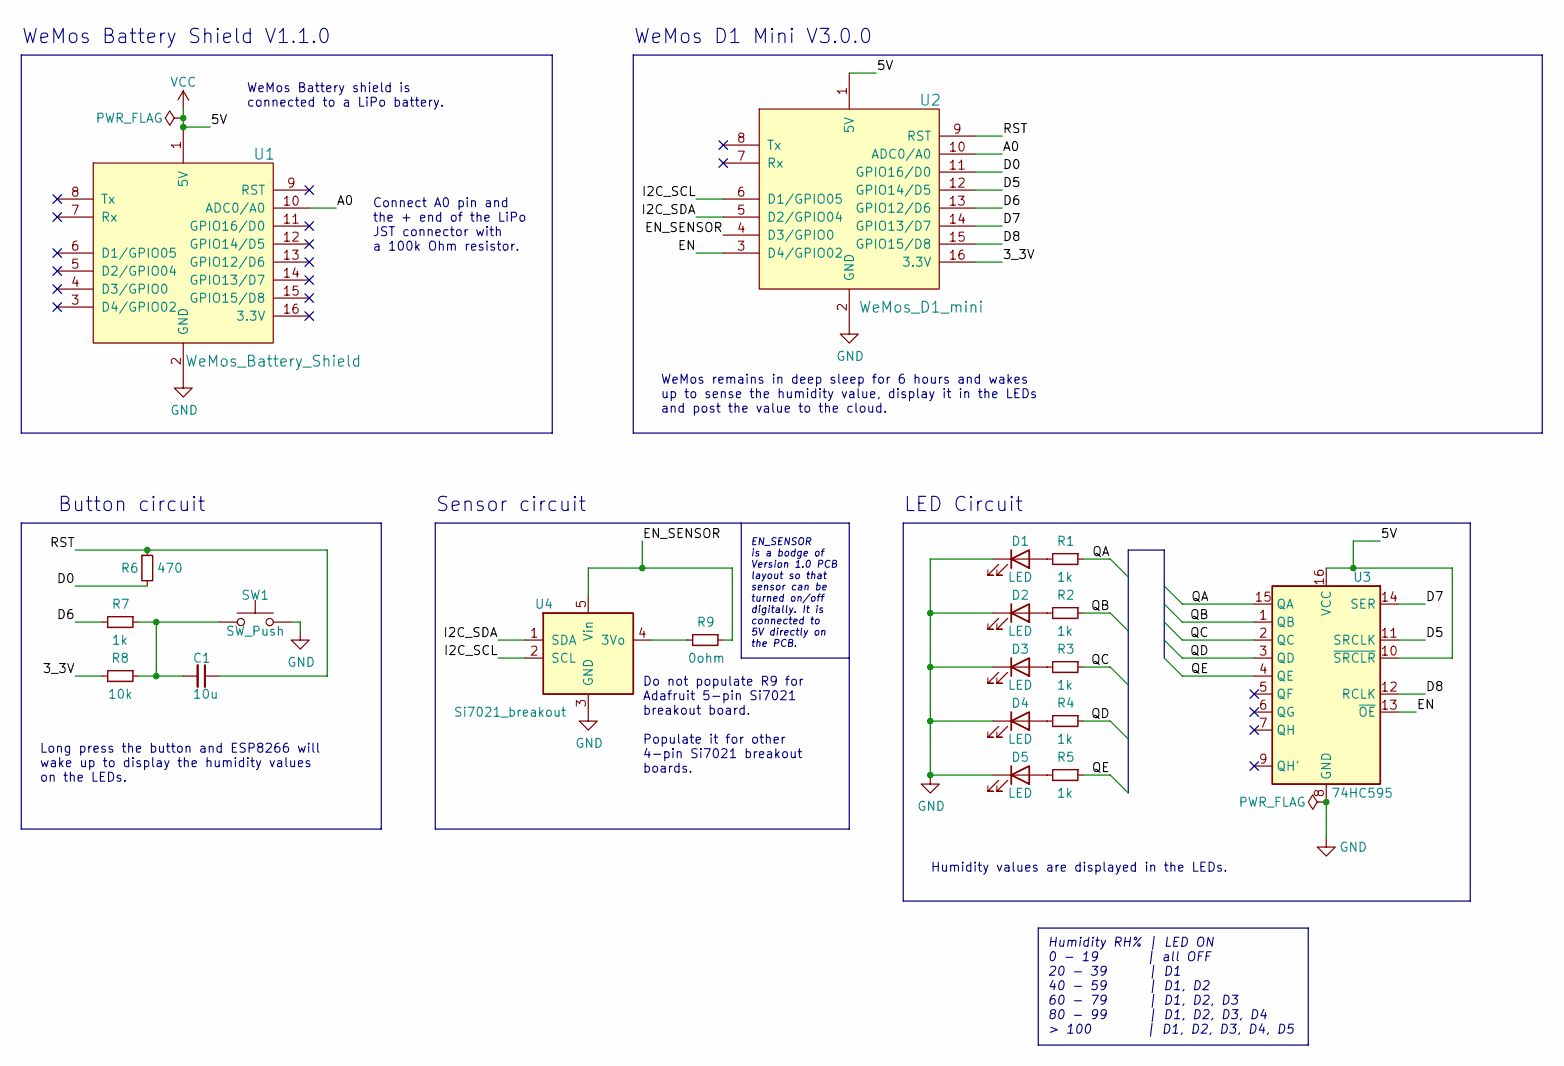
[picture p50: schematic cactus.kicad_sch]

Parts:
C1: 10u; C_0805_2012Metric_Pad1.15x1.40mm_HandSolder
D1, D2, D3, D4, D5: LED; LED_0805_2012Metric_Pad1.15x1.40mm_HandSolder
R1, R2, R3, R4, R5, R7: 1k; R_0805_2012Metric_Pad1.15x1.40mm_HandSolder
R6: 470; R_0805_2012Metric_Pad1.15x1.40mm_HandSolder
R8: 10k; R_0805_2012Metric_Pad1.15x1.40mm_HandSolder
R9: 0ohm; R_0805_2012Metric_Pad1.15x1.40mm_HandSolder
SW1: SW_Push; SW_SPST_EVPBF
U1: WeMos_Battery_Shield
U2: WeMos_D1_mini; D1_mini_board
U3: 74HC595; SOIC-16_3.9x9.9mm_P1.27mm
U4: Si7021_breakout

Connections:
/3_3V: R8.2, U2.16 (3.3V)
/A0: U1.10 (ADC0/A0), U2.10 (ADC0/A0)
/D0: R6.2, U2.11 (GPIO16/D0)
/D5: U2.12 (GPIO14/D5), U3.11 (SRCLK)
/D6: R7.2, U2.13 (GPIO12/D6)
/D7: U2.14 (GPIO13/D7), U3.14 (SER)
/D8: U2.15 (GPIO15/D8), U3.12 (RCLK)
/EN: U2.3 (D4/GPIO02), U3.13 (~OE)
/I2C_SCL: U2.6 (D1/GPIO05), U4.2 (SCL)
/I2C_SDA: U2.5 (D2/GPIO04), U4.1 (SDA)
/QA: R1.1, U3.15 (QA)
/QB: R2.1, U3.1 (QB)
/QC: R3.1, U3.2 (QC)
/QD: R4.1, U3.3 (QD)
/QE: R5.1, U3.4 (QE)
/RST: C1.1, R6.1, U2.9 (RST)
GND: D1.1 (K), D2.1 (K), D3.1 (K), D4.1 (K), D5.1 (K), SW1.2, U1.2 (GND), U2.2 (GND), U3.8 (GND), U4.3 (GND)
unnamed: C1.2, R7.1, R8.1, SW1.1
unnamed: D1.2 (A), R1.2
unnamed: D2.2 (A), R2.2
unnamed: D3.2 (A), R3.2
unnamed: D4.2 (A), R4.2
unnamed: D5.2 (A), R5.2
unnamed: R9.2, U4.4 (3Vo)

Notes on the sheet:
Long press the button and ESP8266 will wake up to display the humidity values on the LEDs.
Humidity values are displayed in the LEDs.
Do not populate R9 for Adafruit 5-pin Si7021 breakout board. Populate it for other 4-pin Si7021 breakout boards.
EN_SENSOR is a bodge of Version 1.0 PCB layout so that sensor can be turned on/off digitally. It is connected to 5V directly on the PCB.
WeMos Battery shield is connected to a LiPo battery.
Connect A0 pin and the + end of the LiPo JST connector with a 100k Ohm resistor.
WeMos D1 Mini V3.0.0
LED Circuit
Button circuit
WeMos Battery Shield V1.1.0
WeMos remains in deep sleep for 6 hours and wakes up to sense the humidity value, display it in the LEDs and post the value to the cloud.
Sensor circuit
Humidity RH% | LED ON 0 - 19 | all OFF 20 - 39 | D1 40 - 59 | D1, D2 60 - 79 | D1, D2, D3 80 - 99 | D1, D2, D3, D4 > 100 | D1, D2, D3, D4, D5

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
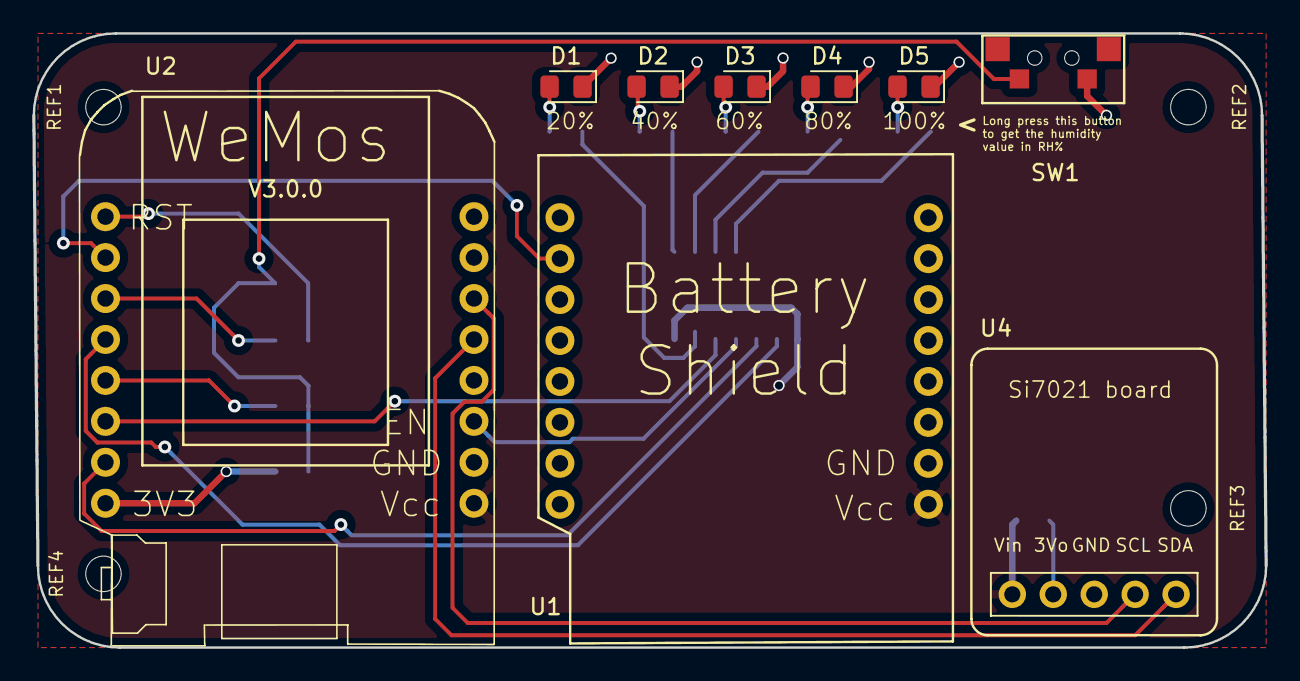
[picture p51: board cactus.kicad_pcb from above]

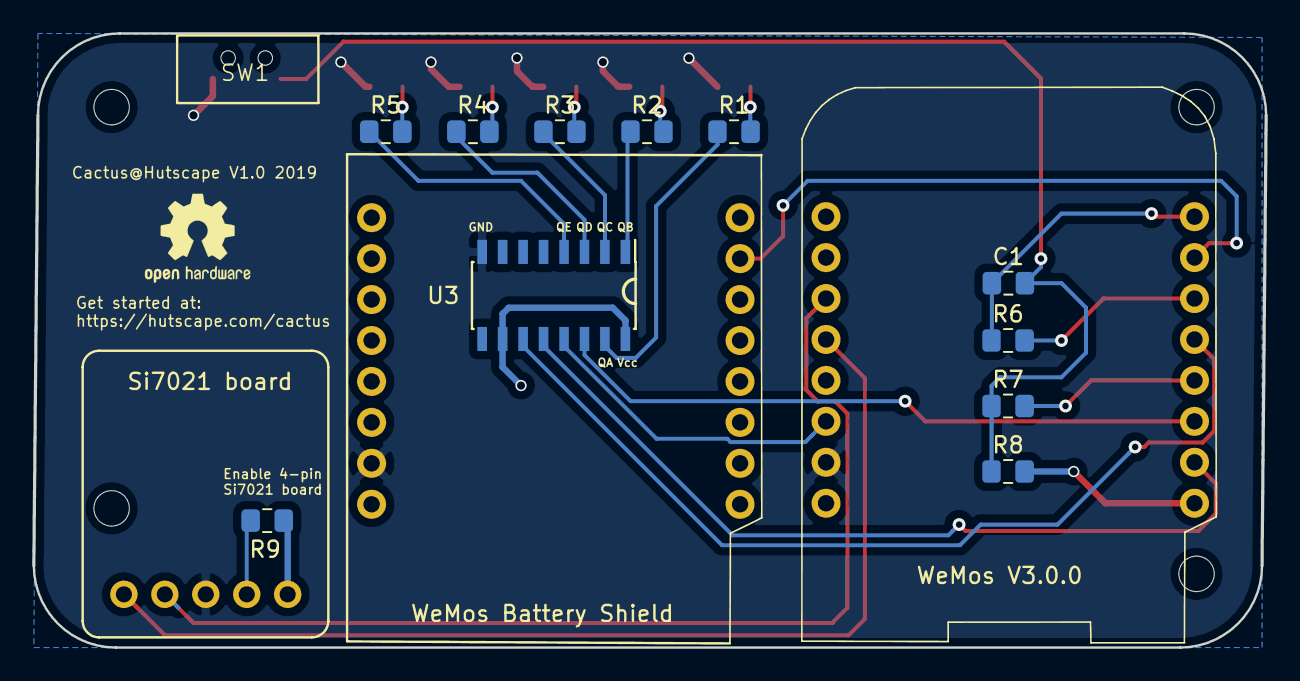
[picture p52: board cactus.kicad_pcb from below]

Board: 2 copper layers, 76.5 x 38.1 mm, 25 parts (12 on the bottom side), 25 nets.

Other parts of the board:
LOGO: OSHW-Logo2_7.3x6mm_SilkScreen
REF1, REF2, REF3, REF4: MountingHole_2.2mm_M2
