hutscape/cactus/(commit log)

2017-05-10 add example with sensor and esp8266
2017-05-15 add preliminary sensor reading values with firmware
2017-05-15 add prototype image
2017-05-16 commit fresh kicad project
    [Hippo.kicad_pcb, Hippo.sch]
2017-06-06 add breakout board schematic reference
2017-06-13 edit bill of materials
    [bill_of_materials.csv]
2017-08-26 Edit sensor firmware code
2017-08-26 Add firmware for shift register and bar LEDs
2017-08-26 Add firmware to display the humidity in bar led
2017-08-27 Add firmware to make an IFTT call with temperature and humidity values
2017-08-27 Add battery holder in BOM
    [bill_of_materials.csv]
2017-09-01 Add a Smidth Trigger to invert the enable signal for shift register during sleep
    [04-ifttt.ino]
2017-09-01 Fix temperature value sent to IFTTT
    [04-ifttt.ino]
2017-09-03 Wakeup and display humidity levels on button press
2017-09-17 Add firmware code for 2 types of humidity sensors
2017-09-17 Fix SDA and SCL pins on ESP8266
    [01-sensor-Si7021.ino]
2017-09-18 Add Fritzing schematic for firmware
    [schematic.fzz]
2017-09-18 Add Fritzing schematic
    [schematic.fzz]
2017-09-18 Remove Arduino IDE settings comments
2017-09-18 Replace wiring instructions with Fritzing schematic
    [schematic.fzz]
2017-09-18 Fix connection for enable pin in schematic
    [schematic.fzz]
2017-09-19 Fix LED on and off
    [ariel.ino]
2017-09-20 Connect /RST to GPIO16 for reset after sleep intervals
    [schematic.fzz]
2017-09-20 Add links to schematic
2017-09-20 Update schematic with button
    [schematic.fzz]
2017-09-20 Update schematic with notes on matching it in firmware
2017-09-24 Add circuit for button press and sleep interval
    [schematic.fzz]
2018-07-31 Create new folder for experiments
    [schematic.fzz]
2018-08-01 Add d-flipflop schematic and code
    [main.ino]
2018-08-02 Use RTC Memory on-board to store count
2018-08-06 Wakeup on button press
2018-11-16 Add schematic for wakeup periodically or on button press
    [schematic.fzz]
2018-11-16 Add images and firmware for periodic wakeup or on button press
2019-02-13 Add more references on power and programming
2019-03-12 Add schematic with sensor and shift register
    [Hippo.sch, ariel.kicad_pcb, ariel.sch]
2019-03-12 Fix power input and output
    [ariel.sch]
2019-03-12 Add easily accessible schematic diagram
2019-03-13 Cleanup schematic and pass ERC
    [ariel.sch]
2019-03-13 Edit labels, fix data bus
    [ariel.sch]
2019-03-13 Add new schematic
2019-03-15 Fix circuit for WeMos and shift register
    [ariel.sch, schematic.fzz]
2019-03-16 Refactor shift register and LED display code
2019-03-18 Update sensor circuit
    [ariel.sch, schematic.fzz]
2019-03-19 Add checklists for schematic and components
2019-03-19 Update symbols for wemos and shield
    [ariel.sch]
2019-03-19 Update to the new schematic image
2019-03-19 Add new symbol for Si7021 breakout board
    [ariel.sch]
2019-03-19 Display humidity values with shift register and LEDs
    [ariel.sch]
2019-03-19 Update enable pin to be connected to the MCU pin instead of GND
2019-03-19 Add 0ohm resistor for flexibility of adding breakout boards
    [ariel.sch]
2019-03-20 Add mechanical pieces
    [ariel.sch]
2019-03-20 Add power consumption theoritical calculations
    [schematic.fzz]
2019-03-20 Link symbols to footprint
    [ariel.sch]
2019-03-21 Add BOM notes
    [ariel.kicad_pcb, ariel.sch]
2019-03-23 Generate net list wirh 0805 instead of 1206
    [ariel.sch]
2019-03-23 Add initial footprint layout
    [ariel.kicad_pcb]
2019-03-24 Tweak WeMos battery shield footprint
    [ariel.kicad_pcb, ariel.sch]
2019-03-25 Edit footprint for battery shield and wemos board
    [ariel.kicad_pcb]
2019-03-26 Layout tracks and fix footprint
    [ariel.kicad_pcb, ariel.sch]
2019-03-26 Pass ERC
    [ariel.kicad_pcb]
2019-03-27 Add OSHW logo, expand copper fill zones
    [ariel.kicad_pcb]
2019-03-28 Note on back silkscreen on enabling 4-pin Si7021 boards
    [_saved_cactus.sch, cactus.kicad_pcb]
2019-03-28 Add mounting holes, more silkscreen annotations
    [_saved_cactus.sch, cactus.kicad_pcb, cactus.sch]
2019-03-28 Add LiPo battery dimensions for design considerations
2019-03-28 Edit battery consumption calculations slightly
2019-03-28 Add PCB fit dimensions incorporating the LiPo battery
2019-03-28 Refer to the PCB diagram
2019-03-29 Add power tree analysis
2019-04-02 [sch] Add pinout info
    [cactus.sch]
2019-04-02 [sch] Amend datasheet for WeMos battery shield
    [cactus.sch]
2019-04-02 [bom] Add KiCad generated BOM
    [bill_of_materials.csv]
2019-04-03 [mech] Add note on long press button on silkscreen
    [cactus.kicad_pcb, cactus.sch]
2019-04-03 [mech] Distribute LEDs and their resistors horizontally
    [cactus.kicad_pcb]
2019-04-03 [mech] Pass ERC with checks for courtyards
    [cactus.kicad_pcb, cactus.sch]
2019-04-03 [mech] Add dimensions to the drawings layer
    [cactus.kicad_pcb]
2019-04-03 [mech] Align reference and values for the LED array
    [cactus.kicad_pcb]
2019-04-03 [bom] Remove unused info from auto-generated bom from KiCad
    [bill_of_materials.csv]
2019-04-03 [mech] Change mounting hole diameter to 2mm
    [cactus.kicad_pcb]
2019-04-04 [mech] Update WeMos D1 mini footprint with document link
    [bill_of_materials.csv]
2019-04-05 [bom] Add order date for BOM
    [cactus.kicad_pcb]
2019-04-05 [mech] Generate gerber
    [cactus-B.CrtYd.gbr, cactus-B.Cu.gbr, cactus-B.Mask.gbr, cactus-B.Paste.gbr, cactus-B.SilkS.gbr, cactus-Edge.Cuts.gbr, cactus-F.CrtYd.gbr, cactus-F.Cu.gbr]
2019-04-05 [mech] Generate gerbers again
    [cactus-B.CrtYd.gbr, cactus-B.Cu.gbr, cactus-B.Mask.gbr, cactus-B.Paste.gbr, cactus-B.SilkS.gbr, cactus-Edge.Cuts.gbr, cactus-F.CrtYd.gbr, cactus-F.Cu.gbr]
2019-04-06 [docs] Pass ERC and DRC on KiCad 5.1
    [cactus.kicad_pcb]
2019-04-08 [docs] Add BOM receive order date
2019-04-10 [bom] Update datasheets of some components
    [cactus.sch]
2019-04-12 [docs] Add timeline for manufacturing PCB
2019-04-15 [docs] Add notes on designing a power on/off switch
2019-04-20 [si] Add test code for LED and shift register
2019-04-20 [si] Test Si7021 temperature and humidity sensor
2019-04-20 [si] Test user button and periodic sleep
2019-04-20 [si] Add test firmware to test hardware integration on PCB
    [schematic.fzz]
2019-04-23 [si] Add fully integrated hardware prototype details
2019-04-24 [si] Add final BOM and costing
    [bill_of_materials.csv]
2019-04-24 [docs] Add notes on battery life and hardware components
2019-04-24 [si] Read and display temperature, humidity and battery levels
2019-04-25 [si] Blink LEDs if WiFi is not connected
2019-04-25 [si] Amend all statements to println
2019-04-26 [si] Read sensor values and send to IFTTT
2019-04-28 [docs] Add reference for measuring LiPo battery level
2019-04-28 [si] Add component code for measuring LiPo voltage and debugging mDNS
2019-04-29 [docs] Rename DHT22-sensor firmware file
2019-04-29 [docs] Rename display-humidity-with-led firmware file
2019-04-29 [docs] Rename long-sleep-or-button-press firmware file
    [schematic.fzz]
2019-04-29 [docs] Rename measure battery voltage firmware file
2019-04-29 [docs] Rename sensor-si7021 firmware file
2019-04-29 [docs] Rename all component firmware so that Arduino can open them directly
    [schematic.fzz]
2019-04-29 [si] Add units for battery voltage measurement
2019-04-29 [si] Rename to firmware.ino so that Arduino can open it directly
2019-04-30 [si] Add battery version and 100k ohm instructions
    [cactus.sch]
2019-04-30 [docs] Add PDFs for schematic and layout and re-arrange readme
2019-04-30 [docs] Amend all main.ino to parent folder names for Arduino IDE
2019-04-30 [si] Test battery voltage data with LiPo
2019-04-30 [docs] Add minor instructions for measuring battery LiPo
2019-04-30 [si] Move test firmware into a seperate folder for Arduino IDE
2019-04-30 [si] Read battery voltage and send to IFTTT with TLS
2019-04-30 [si] Fix format for battery voltage
    [firmware.ino]
2019-05-01 [si] Add todo notes on getting a moving averge sensor values and saving batt
2019-05-01 [si] Add todo task to blink the LEDs in AP mode
2019-05-01 [si] Fix mDNS issue by updating ESP8266 Arduino firmware to latest branch
2019-05-01 [si] Fix mDNS issue by updating ESP8266 Arduino firmware to latest code in master
    [firmware.ino]
2019-05-02 [si] Do not display LEDs if it wakes up automatically after timer interrupt
2019-05-02 [si] Smoothen readings for battery and sensor
2019-05-02 [docs] Add a note on mechanical housing and an opening for env sensors
2019-05-04 [si] Always wakeup without radio to save power
2019-05-05 [docs] Add arduino-cli temporary files to gitignore
2019-05-05 [si] Create more Makefile commands for arduino-cli
2019-05-05 [si] Detect user button press
2019-05-05 [si] Wakeup without WiFi radio to save power, but connect when the sleep count is over
2019-05-05 [si] Refactor serial prints
2019-05-05 [si] Setup Access Point when WiFi connection fails
    [firmware.ino]
2019-05-06 [si] Confirm that LED pin is inverse
2019-05-06 [si] Fix blinking in AP mode
    [firmware.ino]
2019-05-06 [si] Measure sensor and connect to WiFi on button press or wakeup
2019-05-06 [si] Send to Cloud when button pressed or the sleep interval count is up
2019-05-06 [si] Amend bar display for humidity
    [cactus.sch]
2019-05-07 [docs] Move component code DHT22 and displaying humidity with bar LED to another repo
2019-05-07 [docs] Move component code long sleep or on button press to another repo
2019-05-07 [docs] Move component code mdns ap and measure batt voltage to another repo
2019-05-17 [bom] Add 100k resistor patch for WeMos battery shield
    [bill_of_materials.csv]
2019-05-17 [deploy] Ping back to cloud after 6 hours to save battery
2019-05-17 [deploy] Record actual battery life data
2019-05-23 [deploy] Add actual vs calculated power consumption
2019-05-23 [docs] Transfer library files as git submodule
    [cactus.kicad_pcb, cactus.sch]
2019-05-24 [docs] Update kicad library
    [cactus.kicad_pcb]
2019-05-26 [deploy] Fix cpplint errors
    [firmware.ino]
2019-06-01 [bug] Remove extra via in R2. Fixed #10
    [cactus.kicad_pcb]
2019-06-04 [footprint] Add more pin notes on silkscreen
    [cactus.kicad_pcb]
2019-06-06 [design] Add duration for charging
2019-06-06 [firmware] Add tweaks for firmware to enhance battery life
2019-06-06 [docs] Add maintenance notes on charging and flashing firmware
2019-06-30 [docs] Add warning signs for battery shield and USB connectors
2019-07-14 [docs] Add prototype photos on the front page
2019-07-15 [docs] Add link to KiCad files
2019-07-15 [docs] Style design page with power tree and state machine
2019-07-15 [docs] Style power page
2019-07-15 [docs] Render BOM page
    [bill_of_materials.csv]
2019-07-15 [docs] Design BOM page
    [bill_of_materials.csv]
2019-07-16 [docs] Add prototype photos
2019-07-16 [docs] Refactor BOM
    [bill_of_materials.csv]
2019-07-18 [docs] New square prototype photos
2019-07-19 [docs] Remove BOM columns
2019-07-22 [docs] Add money.js to convert BOM cost from SGD to USD
2019-07-22 [docs] Add BOM layout code in a common submodule
2019-07-25 [docs] Remove auto generated CSS for scrollbar in BOM
2019-07-29 [docs] Add more power info
2019-07-30 [docs] Add hyperlinks and improve BOM page
2019-08-01 [docs] Add space in BOM vendors
2019-08-01 [docs] Hide iBOM on touch devices
2019-08-04 [docs] Remove non-data list items from BOM CSV
    [bill_of_materials.csv]
2019-08-07 [docs] Add currency conversion for unit cost and total BOM cost
2019-08-12 [schematic] Add a note on a bodge to control sensor Vin digitally
    [cactus.sch]
2019-08-21 [docs] Add BOM iterator
2019-09-05 [docs] Add bom info generation
2019-09-09 [docs] Move power tree under power
2019-09-16 [docs] Update BOM format
2019-09-18 [docs] Move power diagrams to different folder
2019-09-18 [docs] Update BOM script
2019-09-19 [docs] Improve BOM page
2019-10-11 feat: add sorting and searching for bom
2019-10-24 feat: change footprint to layout naming
2019-10-28 feat: add download buttons on the start page
2019-10-28 feat: add button link for gerber files
2019-11-04 fix: add gerber file download buttons
2019-11-11 chore: update git submodules for scripts and bom
2019-11-28 chore: update KiCad 5.1.5
    [cactus.sch]
2019-12-11 fix: read the correct new event name. close #12
    [firmware.ino]
2021-06-26 chore: updgrade dependancies
    [bill_of_materials.csv]
2021-07-22 fix: update symbol library name
    [cactus.sch]
2021-08-23 refactor: combine design, power and mechanical into design
2021-09-10 fix: reset fonts after inserting iBom
2022-01-08 refactor: better power info meta tags
2022-03-18 chore: update KiCad6 and ruby gems on Monterey
    [cactus.kicad_pcb, cactus.kicad_sch]
2022-04-20 refactor: make a parent data node for download buttons
2022-04-21 refactor: remove gerber_url to link to GitHub releases page
    [cactus-B.Cu.gbr, cactus-B.Mask.gbr, cactus-B.SilkS.gbr, cactus-Edge.Cuts.gbr, cactus-F.Cu.gbr, cactus-F.Mask.gbr, cactus-F.SilkS.gbr, cactus-NPTH.drl]
2022-04-21 "refactor: seperate BOM page into more partials"
2022-05-18 "feat: add 18650 battery 3D model to KiCad library"
2022-05-19 "feat: add stub antenna 3D model to KiCad library"
2022-05-19 "feat: add /case layout for projects with enclosure designs"
2022-07-21 refactor: rename hardware layout to pcb
2022-07-21 refactor: rename directory from hardware to pcb
    [cactus.kicad_pcb, cactus.kicad_sch, cactus.sch]
2022-07-22 chore: move images from hardware to pcb directory
2022-07-25 feat: add 3d printed case photos
2024-02-26 feat: update submodules for unique SMT, DNP and TH BOM parts
2024-02-29 chore: update submodules to seperate /case page into sections
2024-02-29 chore: update submodules to display manufacturing params for case
2024-03-04 feat: display all prototype images until defined max_prototype_images
2024-03-15 chore: update submodules to display software bill of materials
2024-04-01 chore: update submodules to display manufactured PCBs
2024-04-11 feat: add a new power page
2024-04-11 docs (power): remove HTML and convert content to only markdown
2024-05-01 chore: update submodules to sync BOM stats with the manufacturer
2024-11-14 chore: update submodule to conditionally display edit button
